shunliuniliu/QuadBot-TD/README.md

# QuadBot-TD
QuadBot-TA

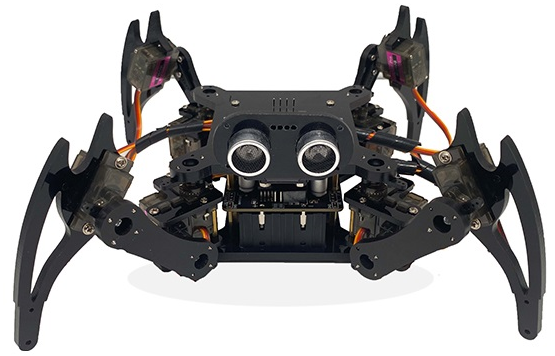
[picture p1: QuadBot-TA.png]


QuadBot-TD

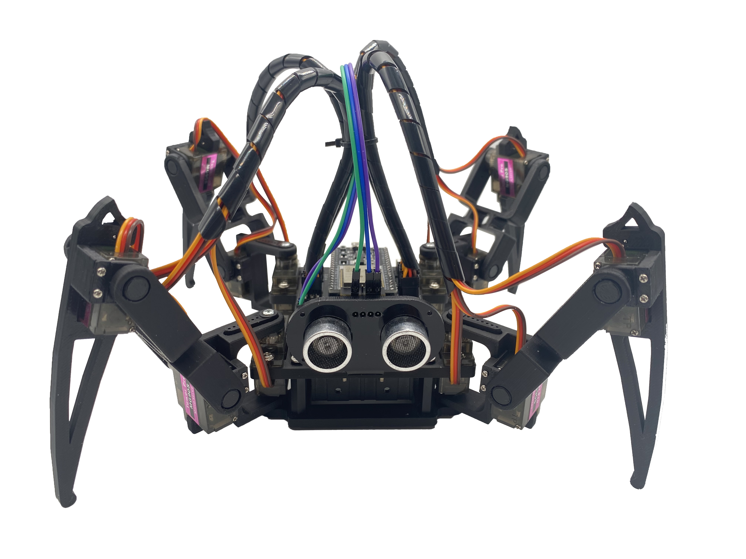
[picture p2: QuadBot-TD.jpg]


QuadBot-TAD

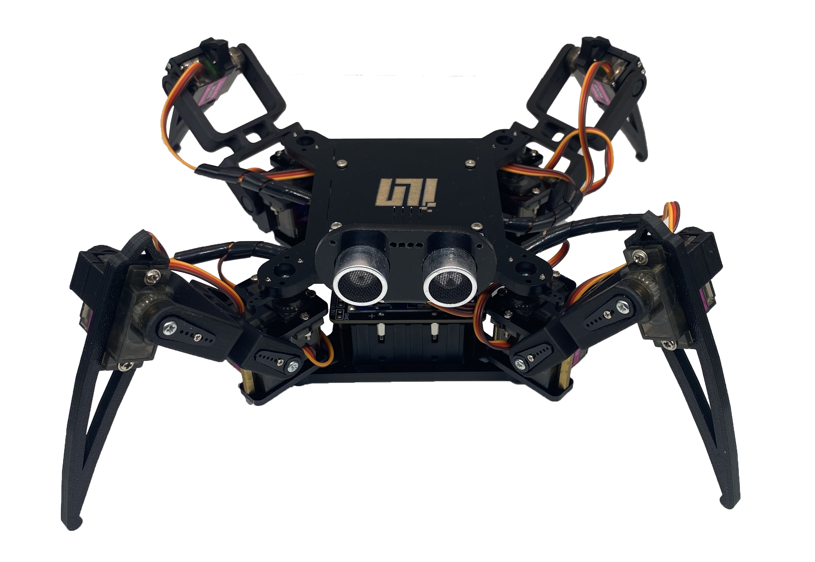
[picture p3: QuadBot-TAD.png]
