shunliuniliu/QuadBot-TD/QuadBot-TAD-EN/01_ReadMeFirst/ReadMe.pdf

1. The new version of the code replaces pin 12 with pin 26, that is, the servo connecting pin 12 in the manual needs to be connected to pin 26 .
2. Please select 18650 battery with flat head .
3. Please fully charge the battery when using it for the first time .
