shunliuniliu/QuadBot-TD/QuadBot-TA.jpg

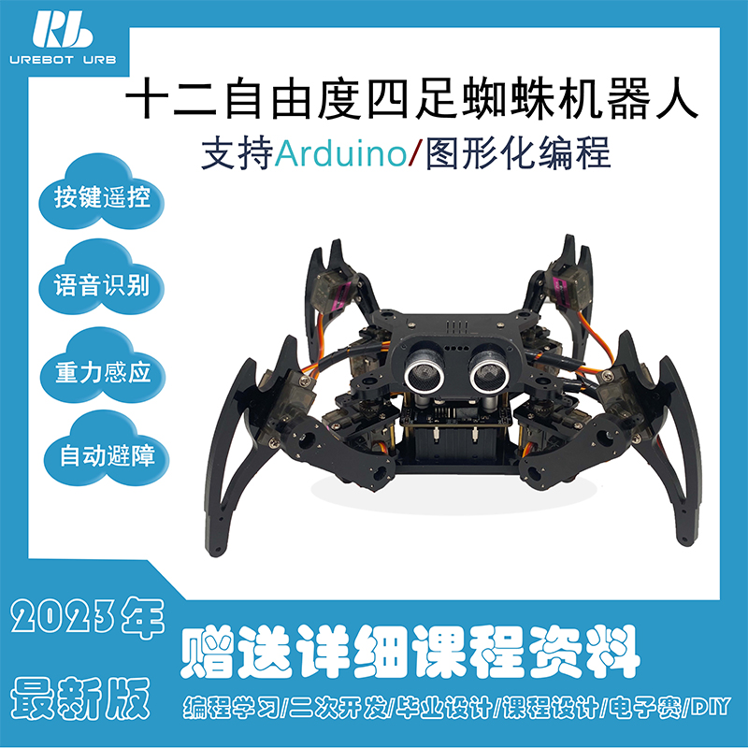
QuadBot-TA.jpg
