shunliuniliu/QuadBot-TD/QuadBot-TAD-EN/09_3D_Model/Body-Down-TAD-V1.0.STL

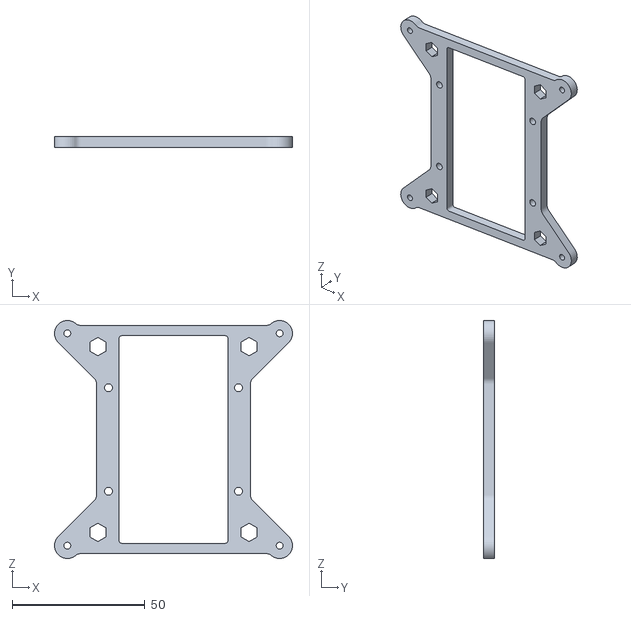
[picture p7: CAD file, 2023-09-18]
QuadBot-TAD-EN/09_3D_Model/Body-Down-TAD-V1.0.STL
89.7 x 4.00 x 89.7
