shunliuniliu/QuadBot-TD/QuadBot-TD-EN/09_3D_Model/S-Hold.STL

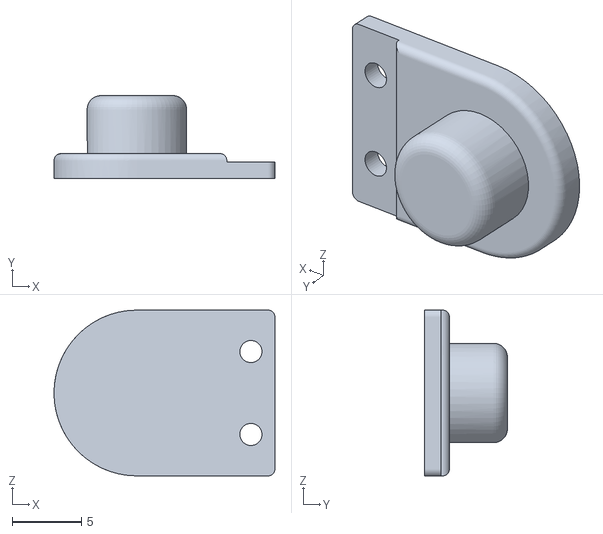
[picture p8: CAD file, 2023-07-27]
QuadBot-TD-EN/09_3D_Model/S-Hold.STL
16.0 x 6.00 x 12.0
