shunliuniliu/QuadBot-TD/QuadBot-TAD-EN/09_3D_Model/Cover-V1.0.STL

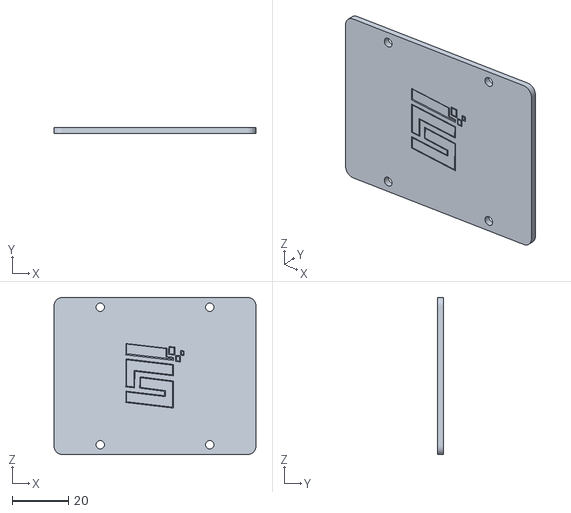
[picture p9: CAD file, 2023-09-18]
QuadBot-TAD-EN/09_3D_Model/Cover-V1.0.STL
72.0 x 2.00 x 56.0
