shunliuniliu/QuadBot-TD/QuadBot-TD-EN/09_3D_Model/Coxa-R-MG90S-V1.0.STL

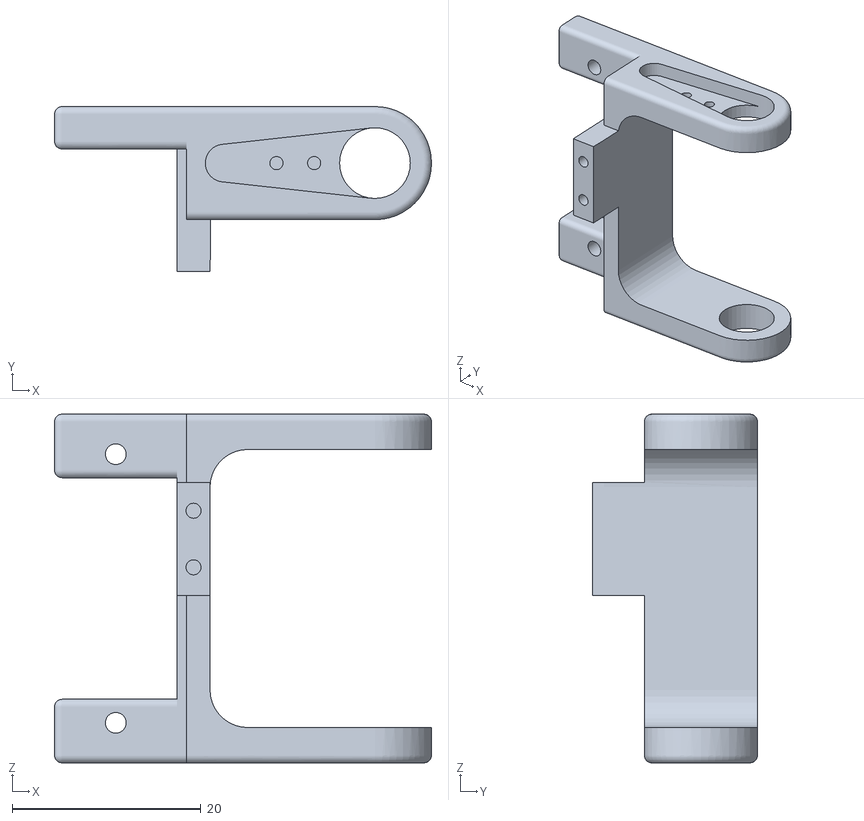
[picture p10: CAD file, 2023-07-27]
QuadBot-TD-EN/09_3D_Model/Coxa-R-MG90S-V1.0.STL
40.0 x 17.5 x 37.0
