shunliuniliu/QuadBot-TD/QuadBot-TAD-EN/09_3D_Model/Body-Up-A-V1.0.STL

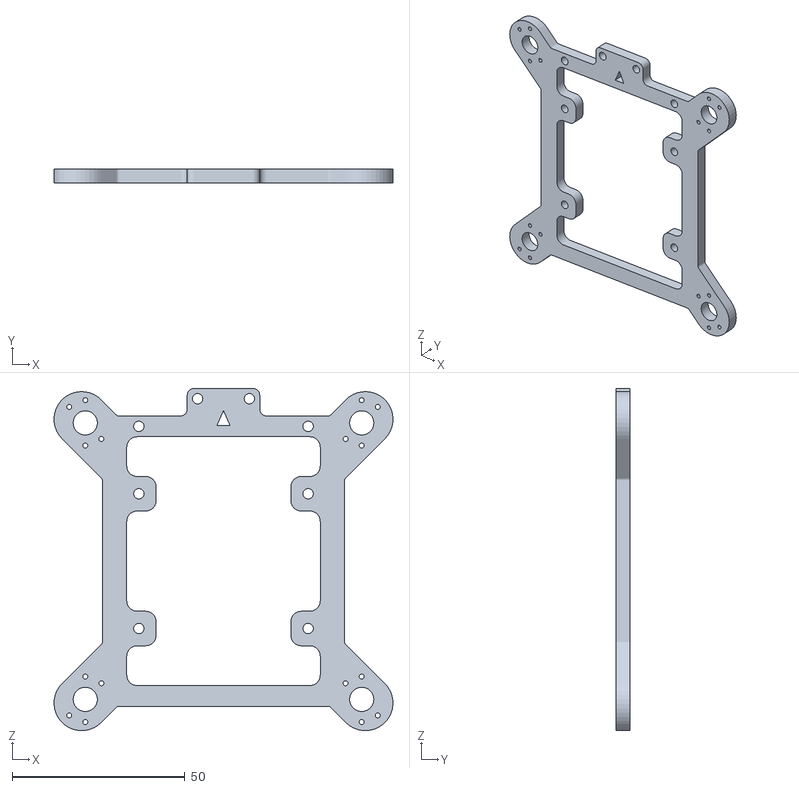
[picture p11: CAD file, 2023-09-18]
QuadBot-TAD-EN/09_3D_Model/Body-Up-A-V1.0.STL
98.1 x 4.00 x 99.1
