shunliuniliu/QuadBot-TD/QuadBot-TD-EN/09_3D_Model/Body-Down-V2.STL

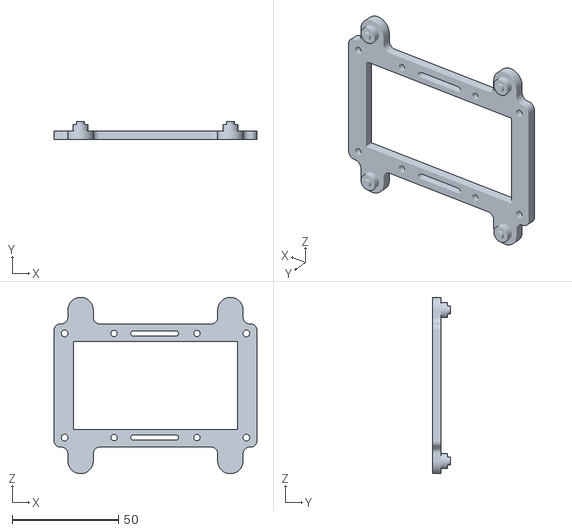
[picture p12: CAD file, 2023-07-27]
QuadBot-TD-EN/09_3D_Model/Body-Down-V2.STL
95.5 x 8.30 x 83.0
