shunliuniliu/QuadBot-TD/QuadBot-TAD-EN/09_3D_Model/Servo-Holder-Up-A-V1.0.STL

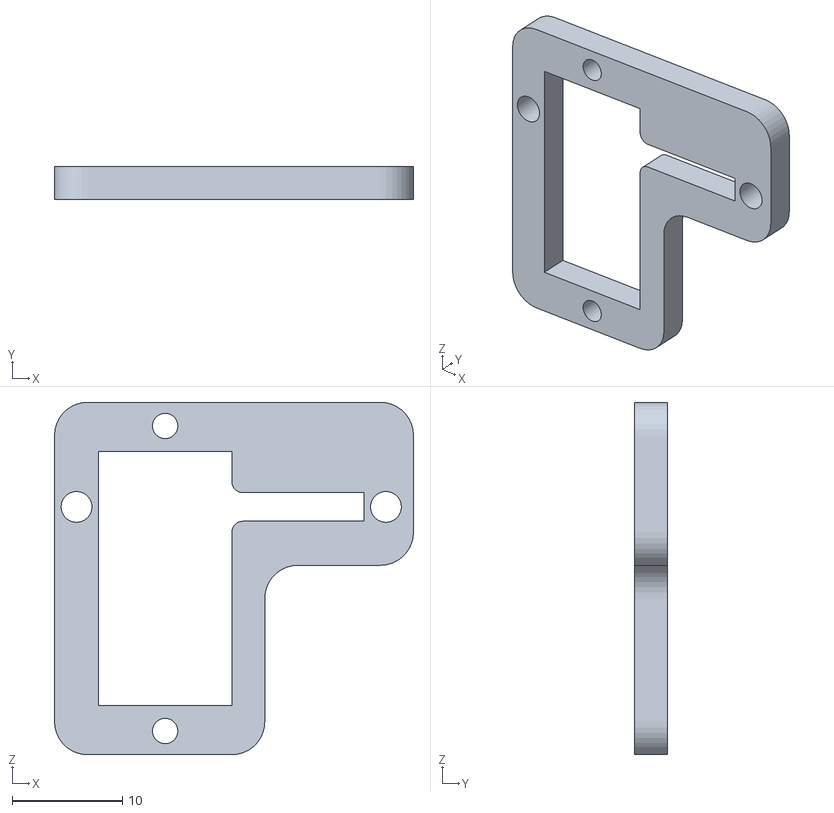
[picture p13: CAD file, 2023-09-18]
QuadBot-TAD-EN/09_3D_Model/Servo-Holder-Up-A-V1.0.STL
32.6 x 3.00 x 32.0
