shunliuniliu/QuadBot-TD/QuadBot-TAD-EN/09_3D_Model/Servo-Holder-Down-A-V1.1.STL

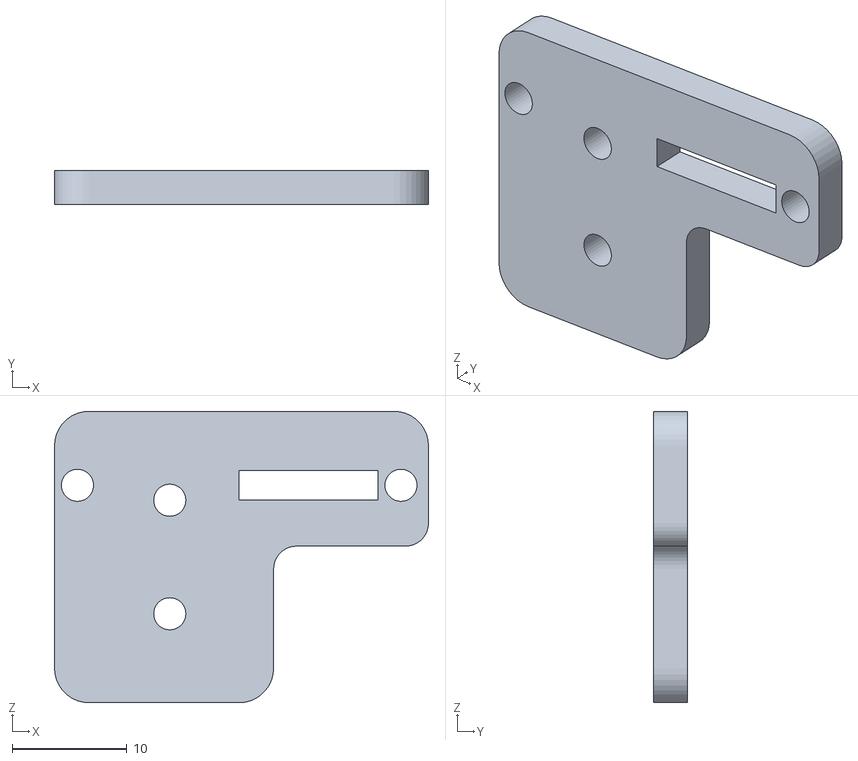
[picture p14: CAD file, 2023-09-18]
QuadBot-TAD-EN/09_3D_Model/Servo-Holder-Down-A-V1.1.STL
32.6 x 3.00 x 25.4
