shunliuniliu/QuadBot-TD/QuadBot-TD-EN/09_3D_Model/ESP32-Body-Up-V1.0.STL

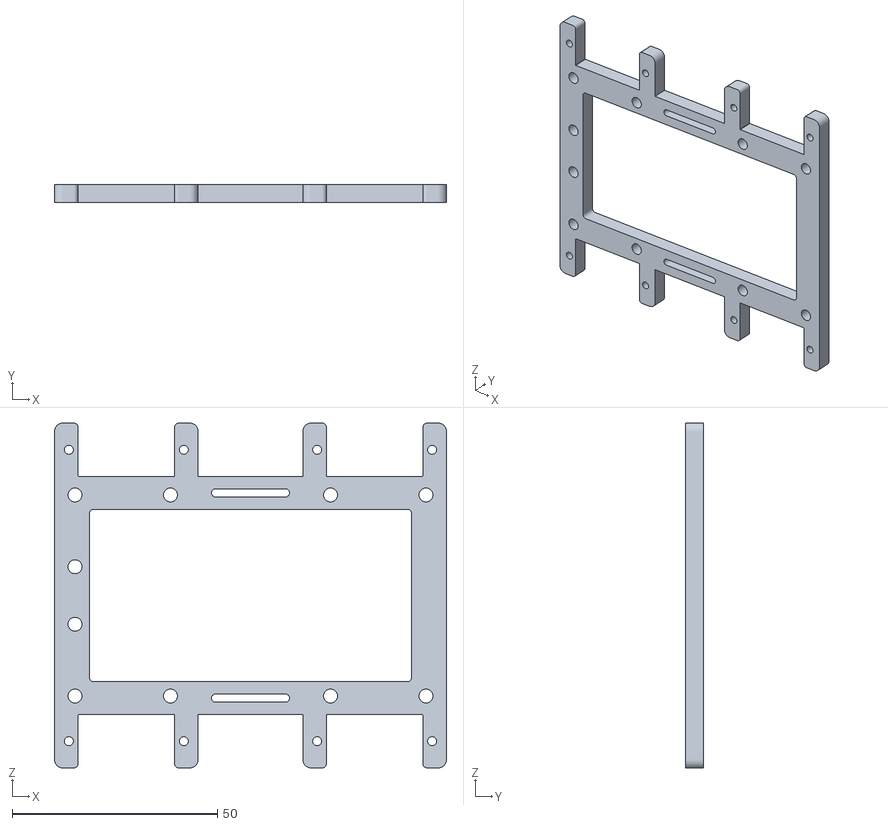
[picture p15: CAD file, 2023-07-27]
QuadBot-TD-EN/09_3D_Model/ESP32-Body-Up-V1.0.STL
95.5 x 4.50 x 84.0
