shunliuniliu/QuadBot-TD/QuadBot-TAD-EN/09_3D_Model/Servo-Bottom.STL

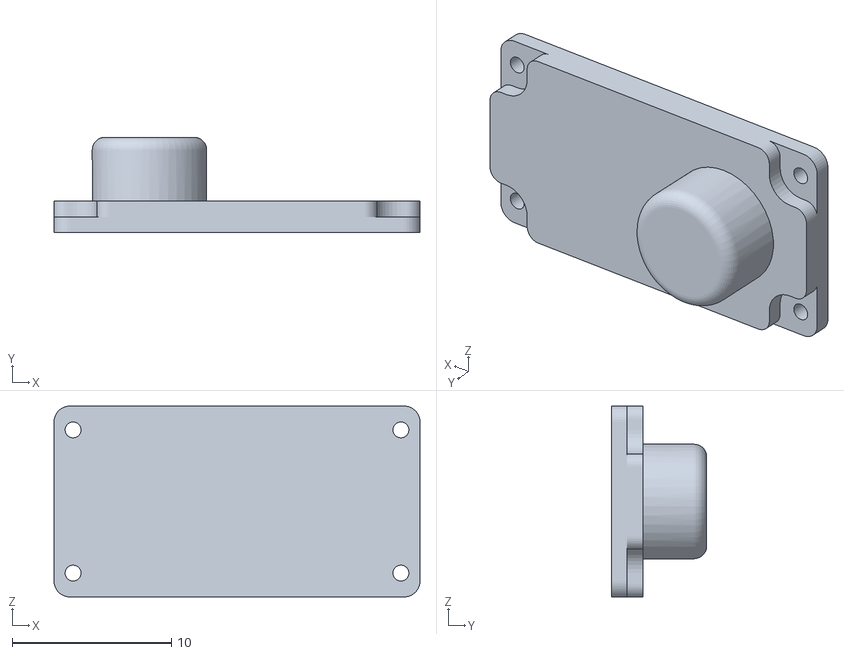
[picture p16: CAD file, 2023-09-18]
QuadBot-TAD-EN/09_3D_Model/Servo-Bottom.STL
23.0 x 6.00 x 12.0
