shunliuniliu/QuadBot-TD/QuadBot-TAD-EN/09_3D_Model/Sonar-Holder-V2.0.STL

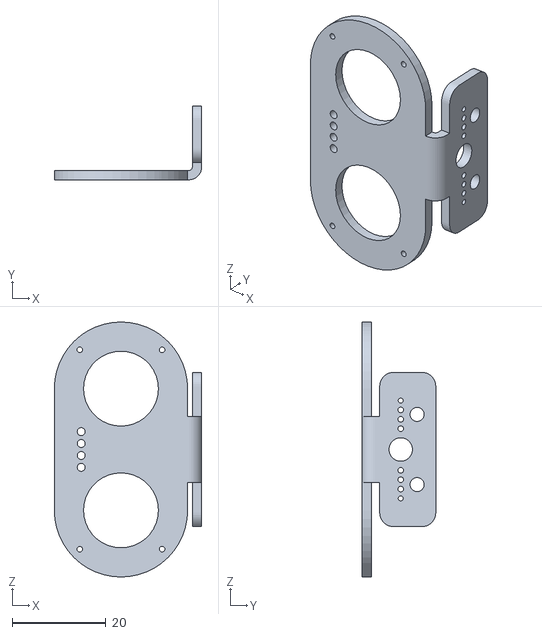
[picture p17: CAD file, 2023-07-27]
QuadBot-TAD-EN/09_3D_Model/Sonar-Holder-V2.0.STL
31.5 x 15.7 x 54.5
