shunliuniliu/QuadBot-TD/QuadBot-TAD-EN/09_3D_Model/Tibia-L-MG90S.STL

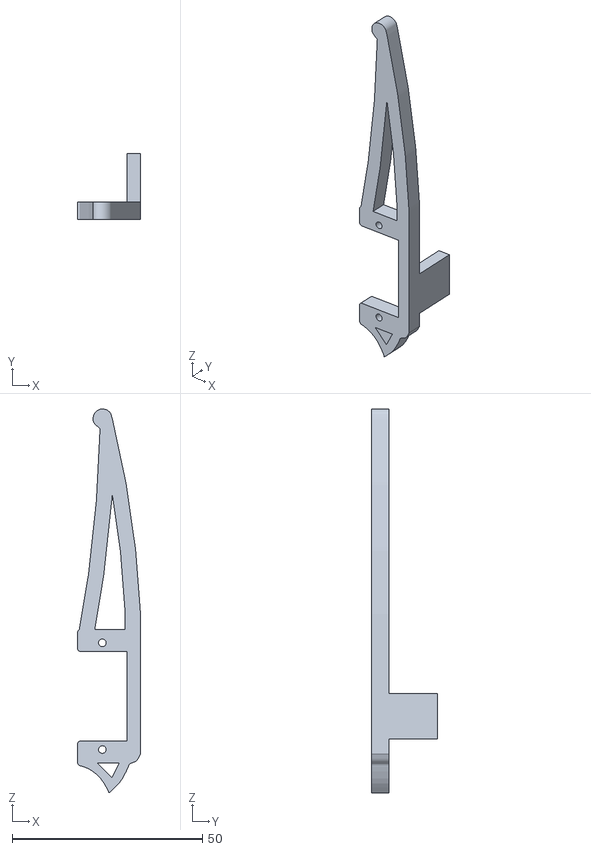
[picture p18: CAD file, 2023-07-27]
QuadBot-TAD-EN/09_3D_Model/Tibia-L-MG90S.STL
16.5 x 17.3 x 100.8
