shunliuniliu/QuadBot-TD/QuadBot-TAD-EN/09_3D_Model/Tibia-R-MG90S.STL

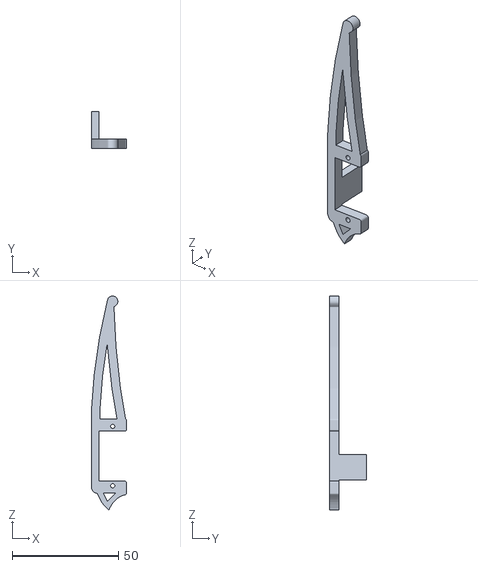
[picture p19: CAD file, 2023-07-27]
QuadBot-TAD-EN/09_3D_Model/Tibia-R-MG90S.STL
16.5 x 17.3 x 100.8
