shunliuniliu/QuadBot-TD/QuadBot-TAD-EN/09_3D_Model/Femur-MG90S-V1.0.STL

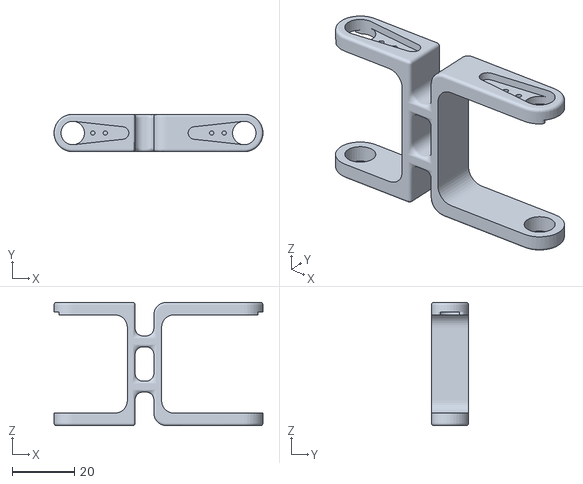
[picture p20: CAD file, 2023-07-27]
QuadBot-TAD-EN/09_3D_Model/Femur-MG90S-V1.0.STL
67.0 x 12.0 x 39.5
