shunliuniliu/QuadBot-TD/(list of files, cad)

Other CAD files:
QuadBot-TD-EN/09_3D_Model/Coxa-L-MG90S-V1.0.STL
