shunliuniliu/QuadBot-TD/QuadBot-TAD-EN/03_Tutorial_&_Code/Lesson0 Setting Development Enviornment/Lesson0 Setting Development Enviornment.pdf

# Arduino IDE

Arduino IDE, as an open source software, is developed based on the Processing IDE and is an integrated development environment officially launched by Arduino

The QuadBot-T kit was programmed and debugged using the Arduino IDE

## So, where can we download the arduino IDE?

## Step 1:

Go to https://www.arduino.cc/en/Main/Software, you will see the following page. The version provided on this website is usually the latest version, the actual version may be more recent than the version in the picture. Version 1.8.19 is recommended.

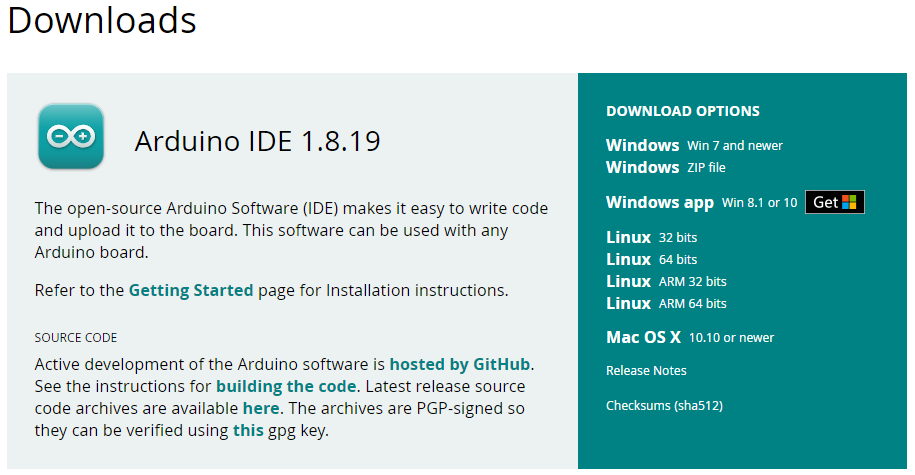
[picture p21: figure]

## Step 2:

Download development software suitable for your computer's operating system. Take Windows as an example. If you are a macOS, please pull to the end. You can use the EXE installation package or the green package.
The following is the executable for the installer. Click on "Windows Installer" as shown in the picture below。

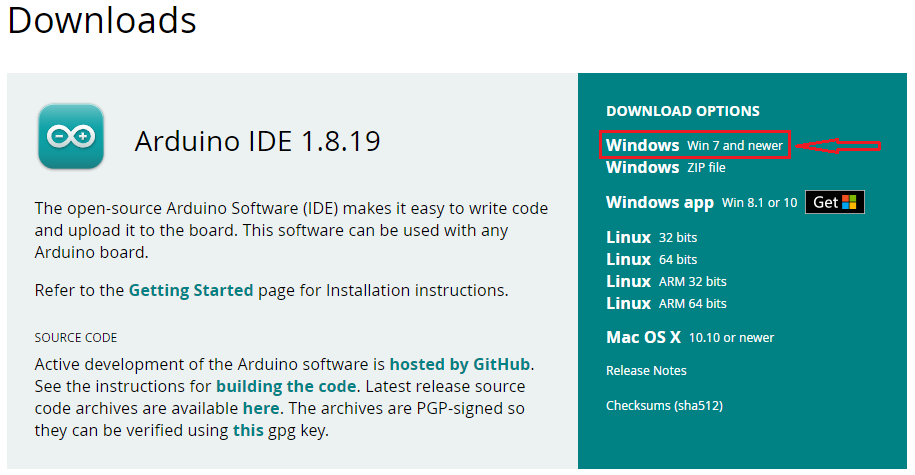
[picture p22: figure]

## Step 3:

The following interface appears. Click the "JUST DOWNLOAD" button to download the software.

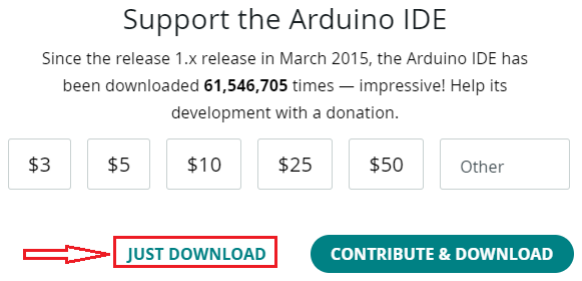
[picture p23: figure]

Download file：

## Step 4:

These are available from the tutorials we provide, and the version we provide is the most recent at the time this course was produced. Double-click the exe file. The following interface appears. Select "I Agree".
。

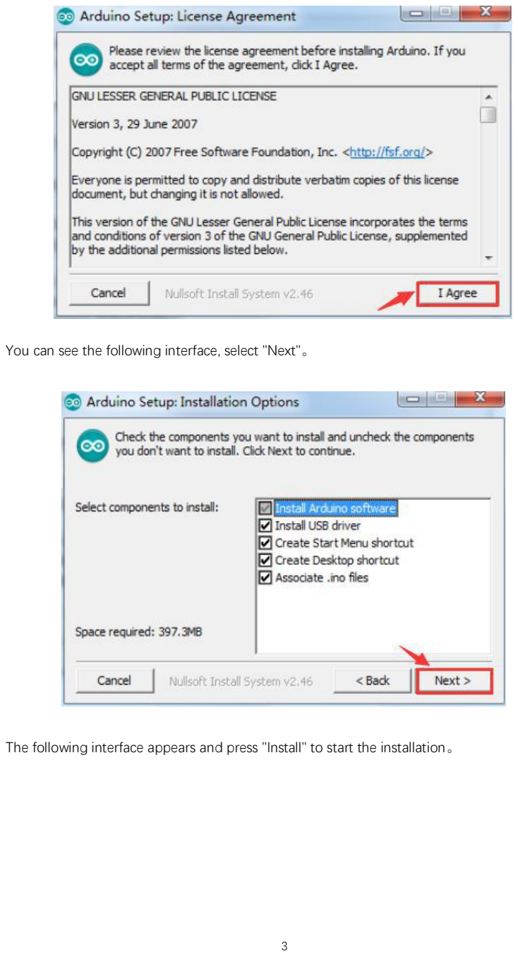
[picture p24: page 3]

You can see the following interface, select "Next"。

The following interface appears and press "Install" to start the installation。

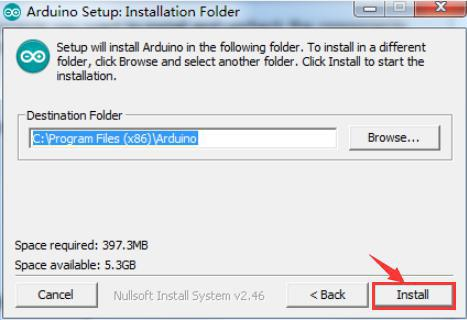
[picture p25: figure]

Finally, the following interface appears. Please select "Install" to ensure the correctness of the development environment installation。

## Step 5:

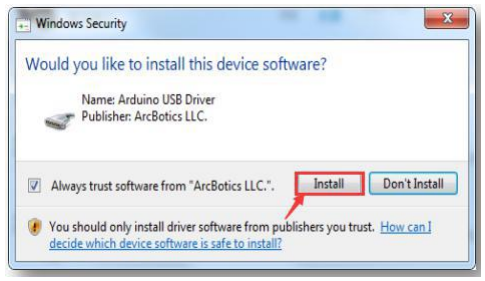
[picture p26: figure]

Next, the following icons will appear on the desktop。

Double-click the icon to enter the development environment。

## Step 6:

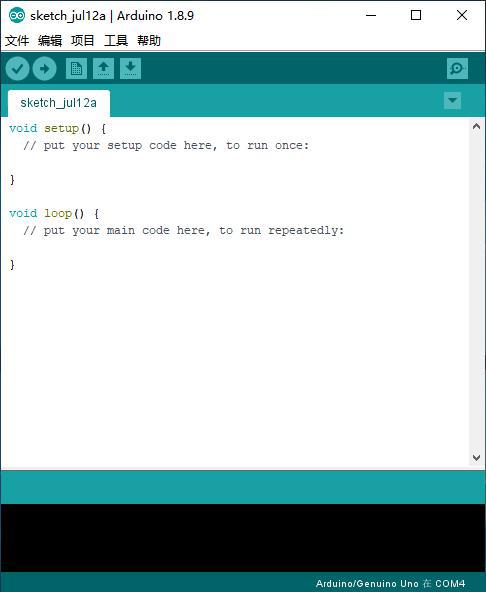
[picture p27: figure]

The main controller we use here is ESP32-WROOM-32，so you need to install the ESP32 plug-in，in the Arduino IDE opened in the previous step, find "File ->Preferences"。Add the
following | web | address | to | the | "Add-on | Board | Manager | web | address:"
https://dl.espressif.com/dl/package_esp32_index.json，as shown in the figure below。

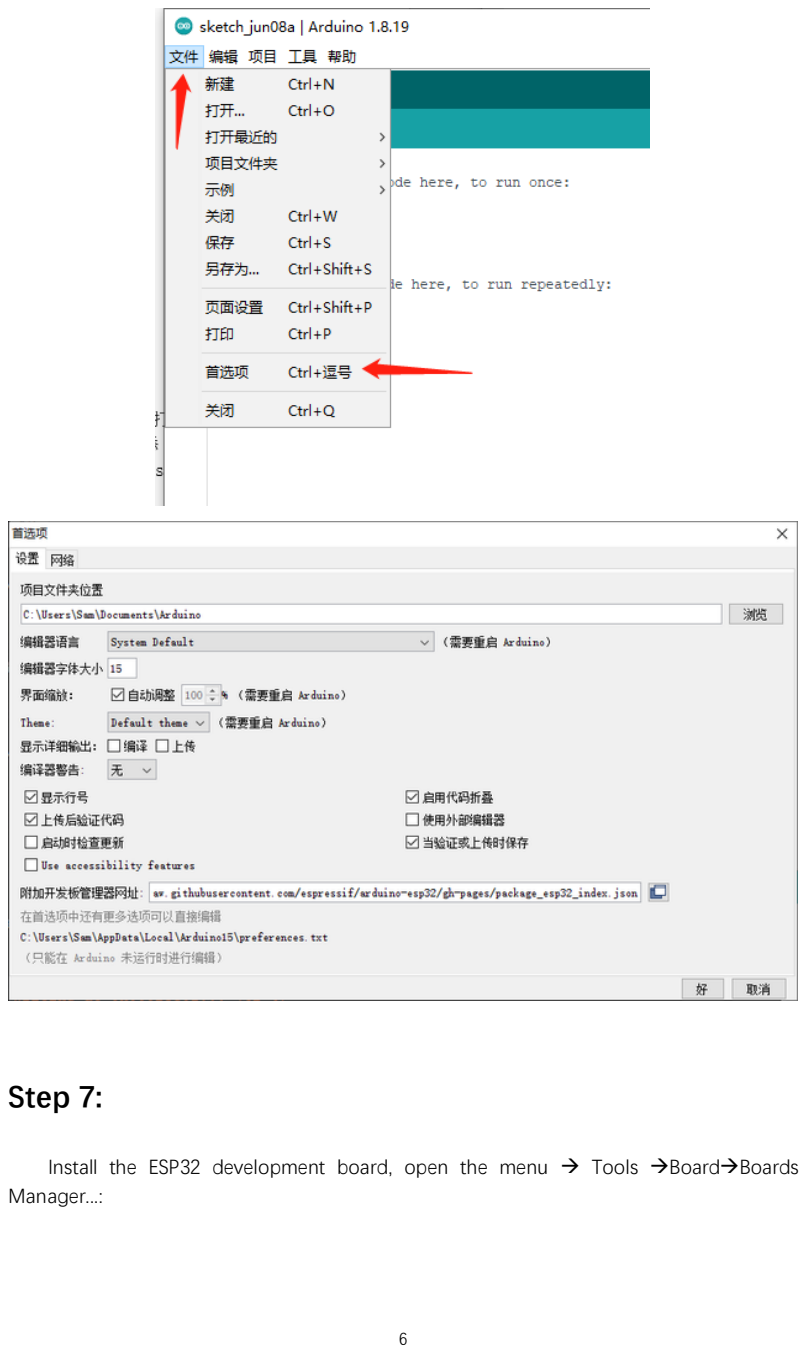
[picture p28: page 6]

## Step 7:

Install the ESP32 development board, open the menu → Tools →Board→Boards Manager...:

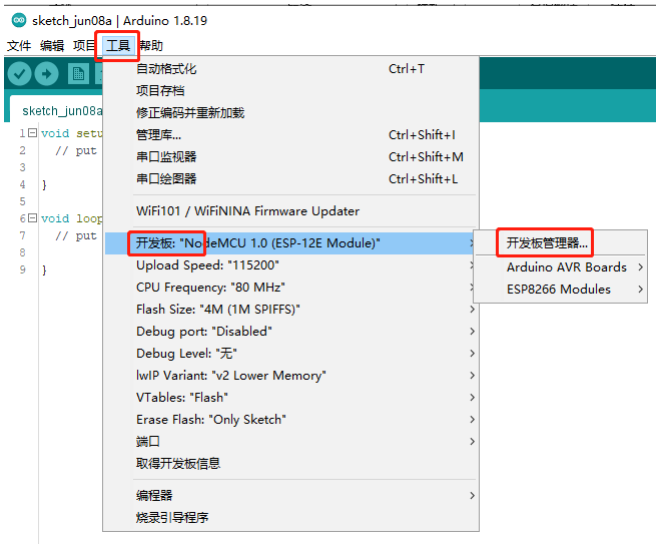
[picture p29: figure]

开发板管理器入口

Enter esp32 in the boards manager to search for the esp32 development board, and then

click Install, as shown in the following figure（Note: Version 1.0.6 needs to be

## installed！！！）

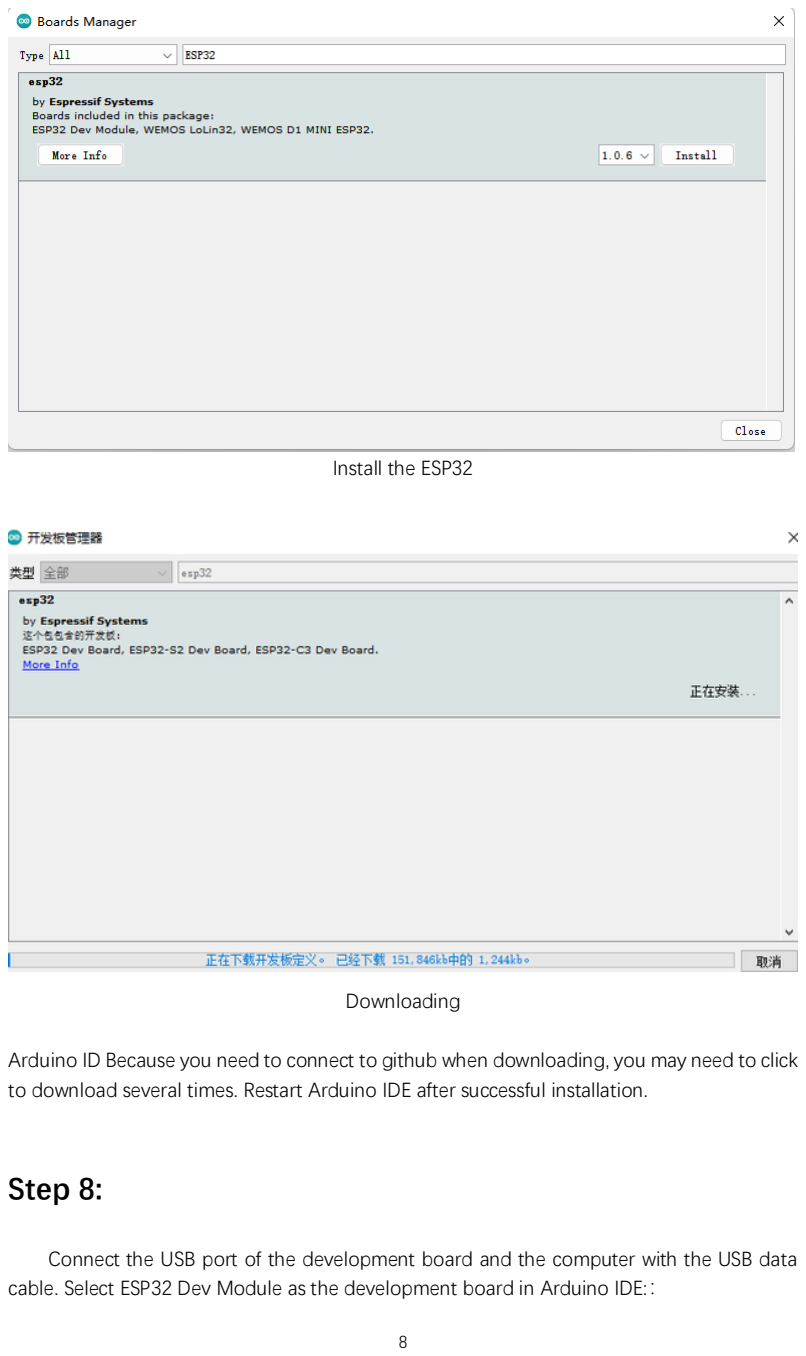
[picture p30: page 8]

Install the ESP32

Downloading

Arduino ID Because you need to connect to github when downloading, you may need to click to download several times. Restart Arduino IDE after successful installation.

## Step 8:

Connect the USB port of the development board and the computer with the USB data cable. Select ESP32 Dev Module as the development board in Arduino IDE:：

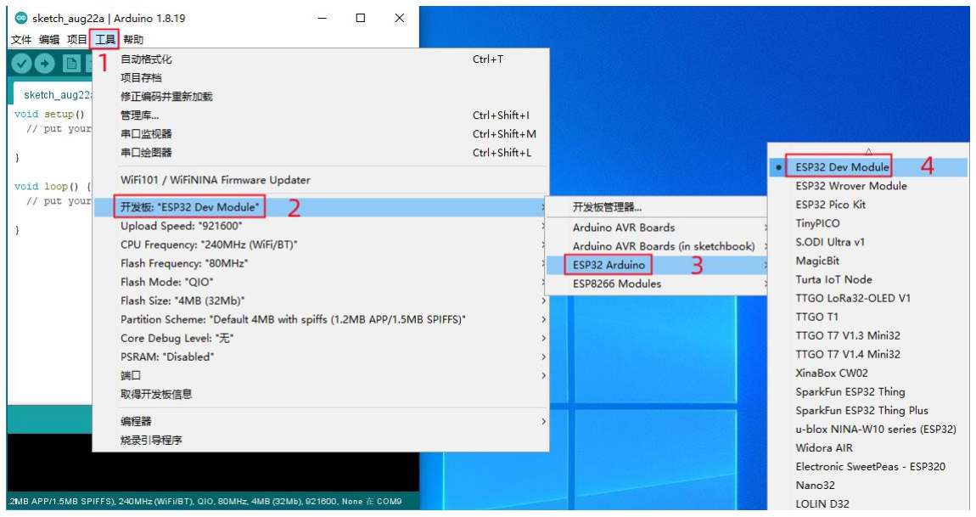
[picture p31: figure]

## Step 9:

Test whether the software is installed successfully. Click "File → Example → ESP32 → ChipID → GetChipID" in turn. Select "COM9" in "Tools" ->"Port". (On the same computer in Arduino 1.8.9, each ESP32 development board has a different COM number. You should select the COM number actually displayed.)

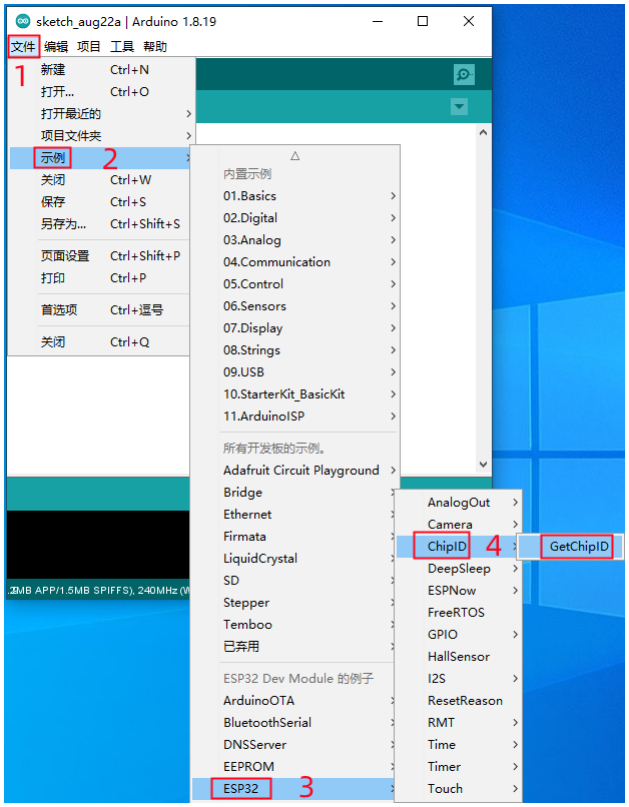
[picture p32: figure]

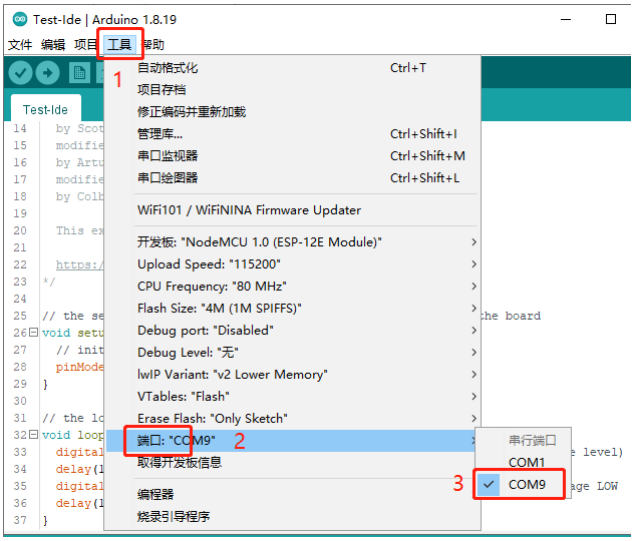
[picture p33: figure]

## Step 10:

Click the download button to download the program into ESP32. As shown in the figure below.

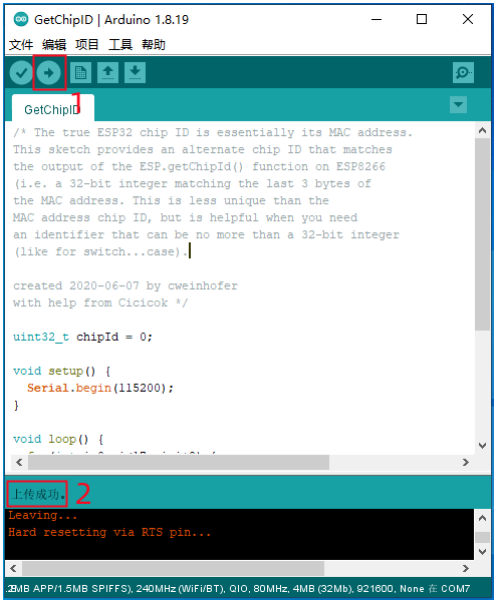
[picture p34: figure]

When you see the prompt "Upload succeeded" in prompt 2, the download is completed.

## Step 11:

Click the Serial Monitor button in the upper right corner. As shown in the figure below：

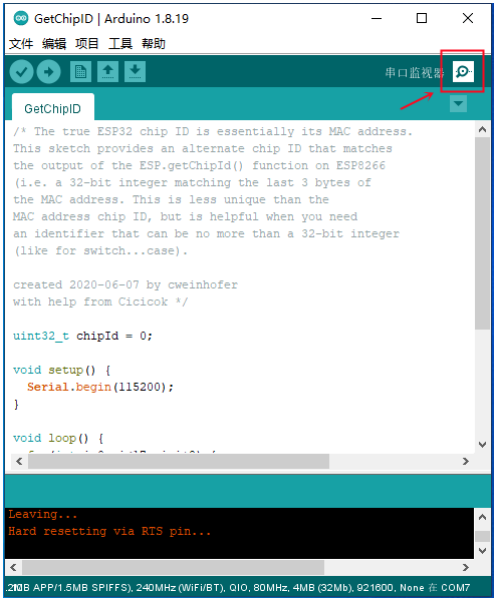
[picture p35: figure]

Select 115200 baud rate in the pop-up Serial Monitor window, as shown below:

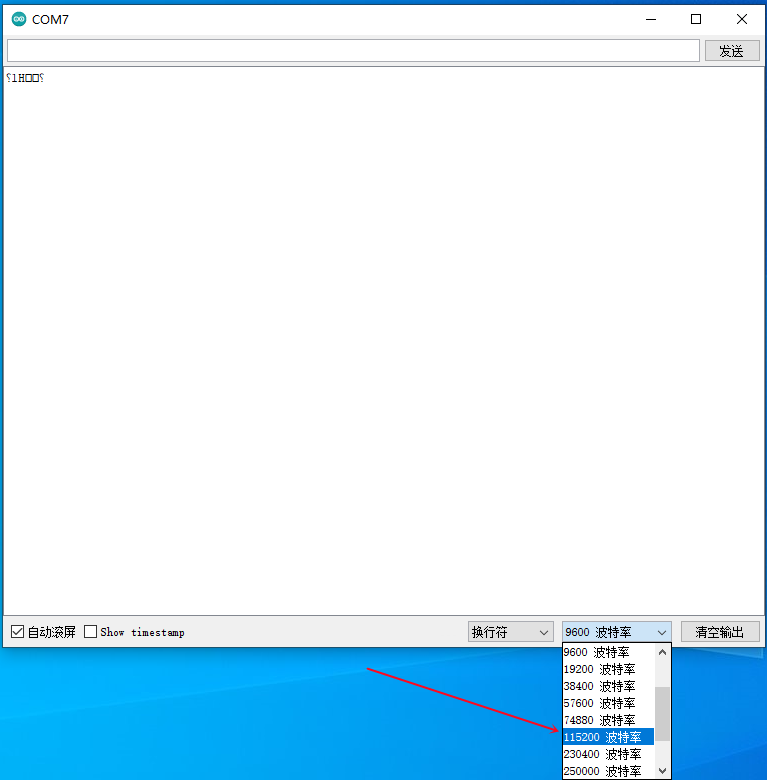
[picture p36: figure]

Under normal circumstances, you can see that the ID information of the chip is displayed correctly in the window. So far, the Arduino IDE software has been successfully installed.
