shunliuniliu/QuadBot-TD/QuadBot-TAD-EN/03_Tutorial_&_Code/Lesson6 Mobile App Control Robot/Lesson6 Mobile App Control Robot/Lesson6 Mobile App Control Robot.pdf

# 1. Mobile phone APP control

## 1.1. Open the source code

Open the information package we provide, locate to the "Course 7 Mobile APP Control Q uad Bot_T _ESP D" folder, and double-click Q uad Bot_T _ESP D. And ino, open the source code.→→

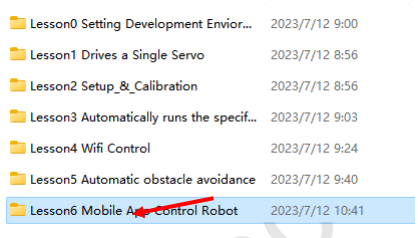
[picture p89: figure]

## 1.2. To compile the source code

Click the 1 compile button as shown in the figure below. If there is no problem, the compilation completion prompt in 2 appears.

# Urebot

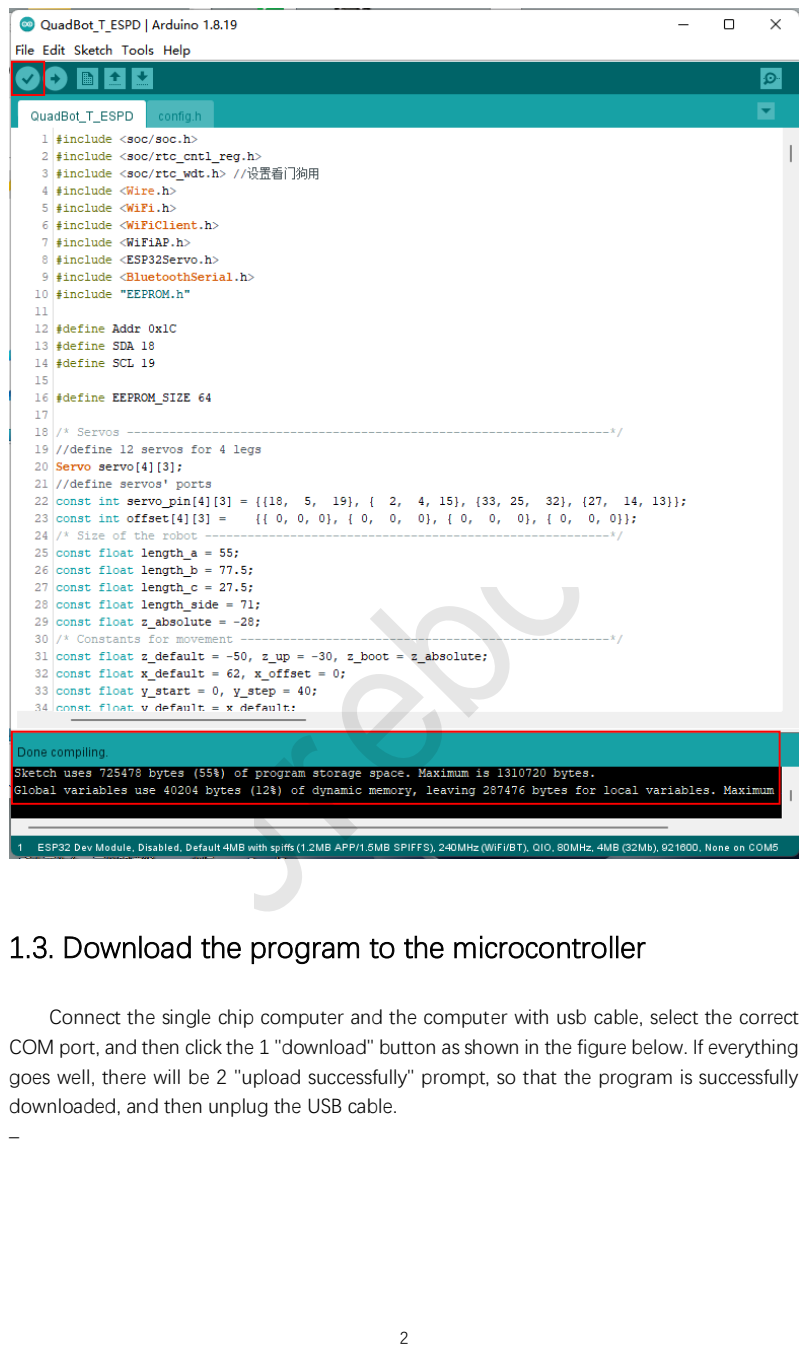
[picture p90: page 2]

## 1.3. Download the program to the microcontroller

Connect the single chip computer and the computer with usb cable, select the correct COM port, and then click the 1 "download" button as shown in the figure below. If everything goes well, there will be 2 "upload successfully" prompt, so that the program is successfully downloaded, and then unplug the USB cable.
–

# Urebot

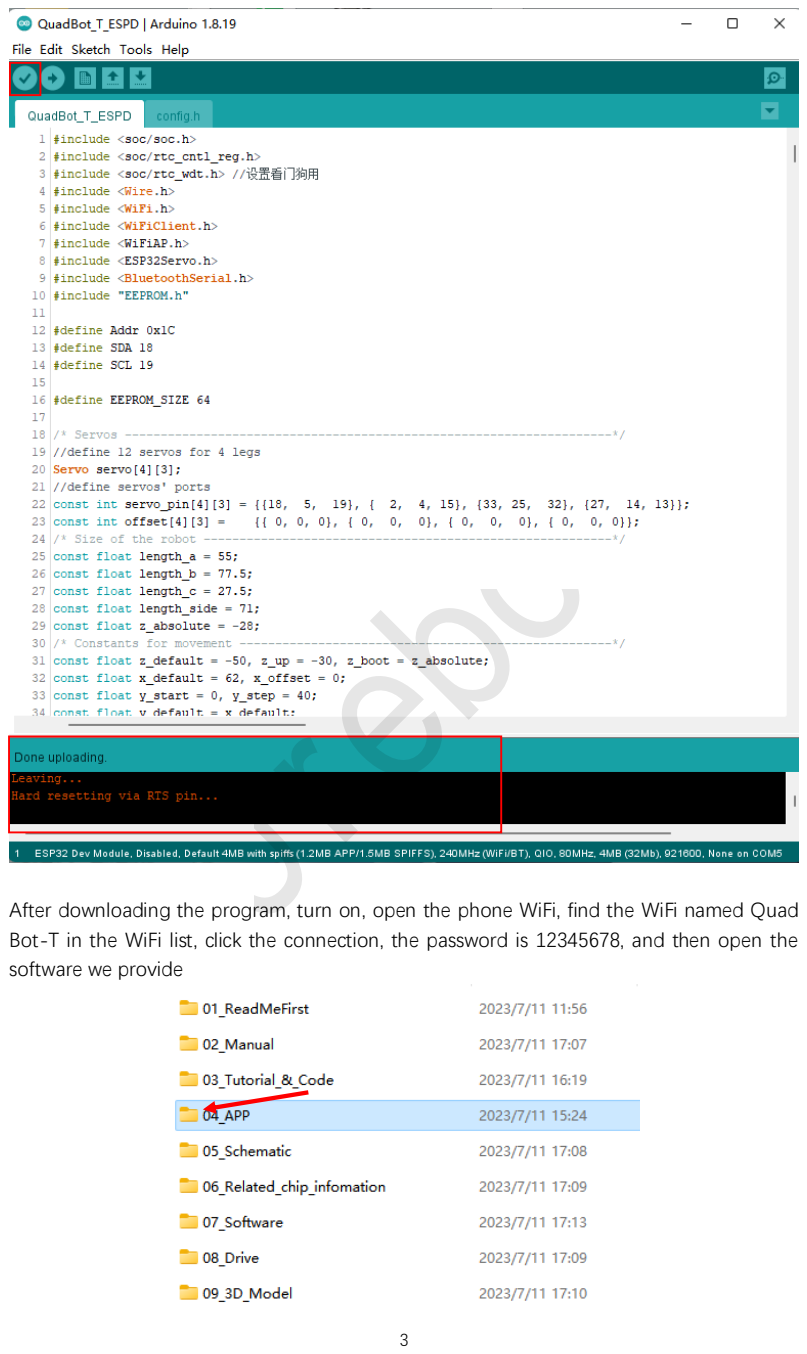
[picture p91: page 3]

After downloading the program, turn on, open the phone WiFi, find the WiFi named Quad Bot-T in the WiFi list, click the connection, the password is 12345678, and then open the software we provide

# Urebot

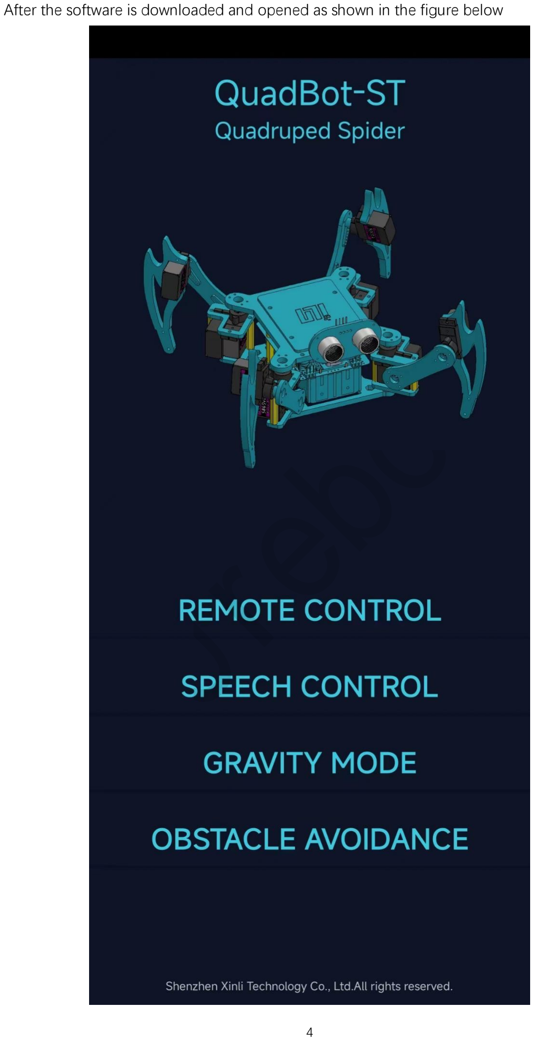
[picture p92: page 4]

After the software is downloaded and opened as shown in the figure below

# Urebot

1. Key control, which can be manually controlled

# Urebot

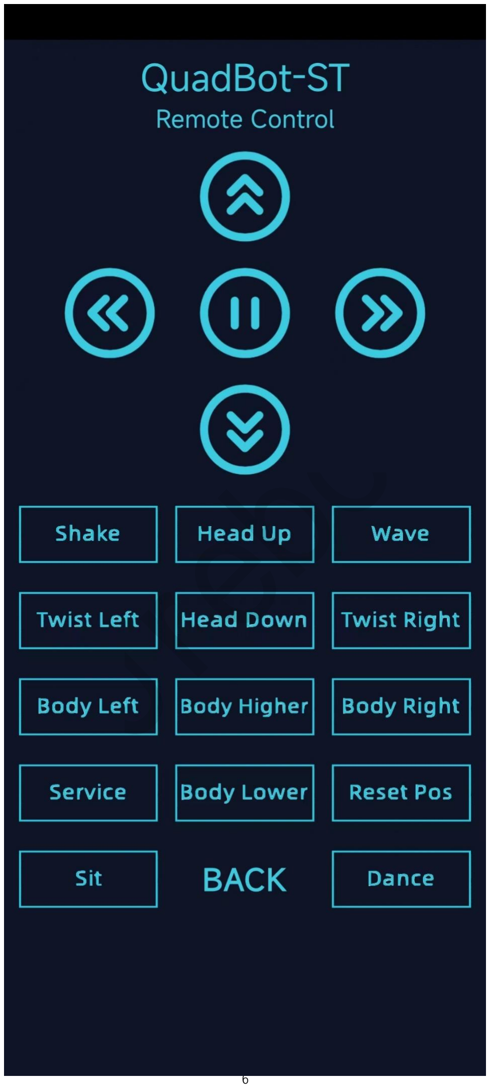
[picture p93: page 6]

# Urebot

2. Voice remote control, when you hold the microphone in the middle of the screen, and then release,
(Instruction: forward, back, turn left, turn right, look up, wave, shake hands, left twist, right twist, lift, squat, service, reset, sit, dance), the spider performs the corresponding action

# Urebot

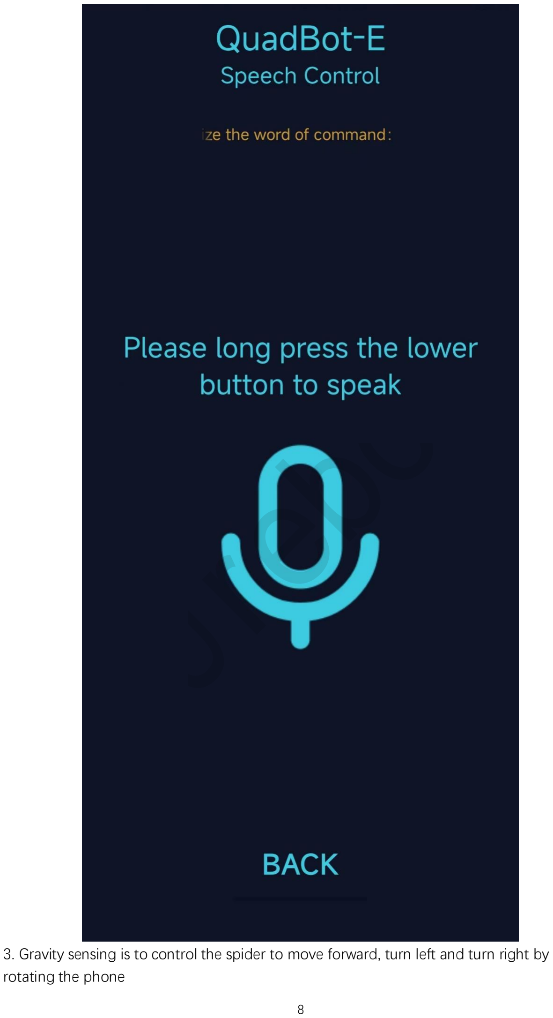
[picture p94: page 8]

3. Gravity sensing is to control the spider to move forward, turn left and turn right by rotating the phone

# Urebot

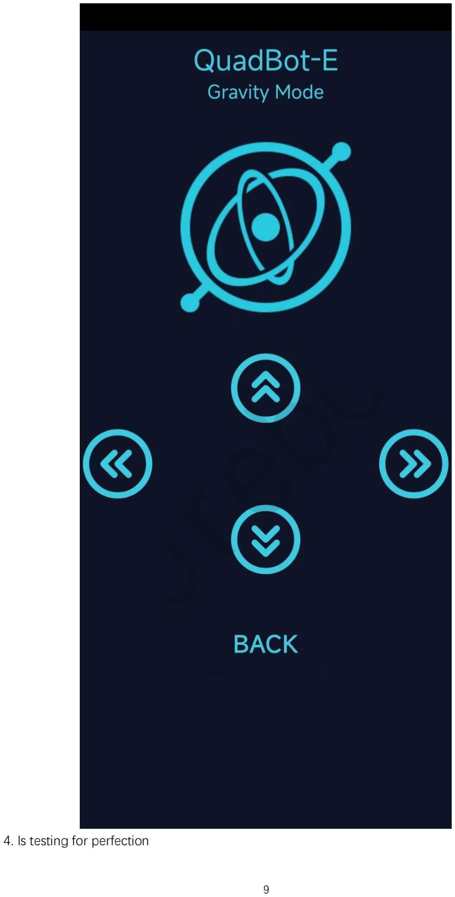
[picture p95: page 9]

4. Is testing for perfection

# Urebot

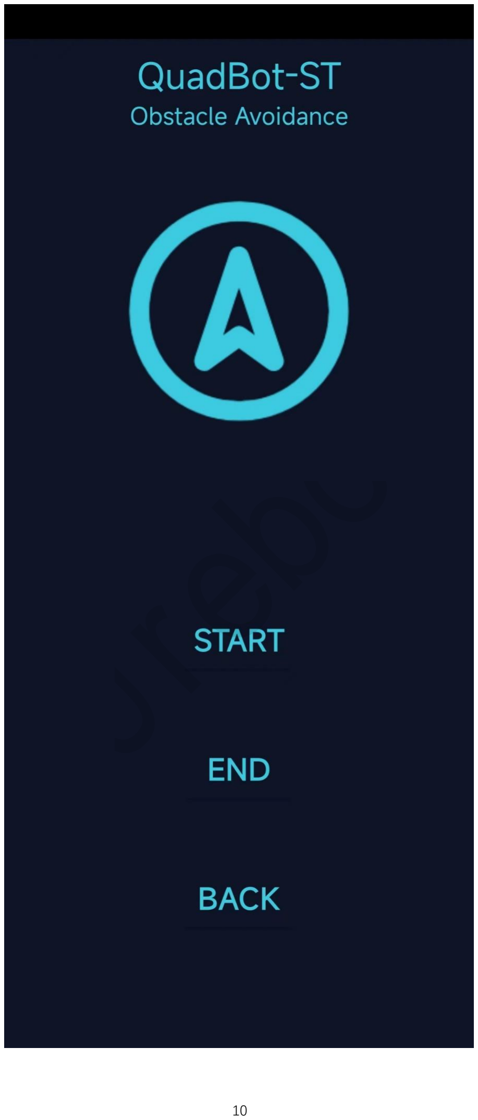
[picture p96: page 10]

# Urebot
