shunliuniliu/QuadBot-TD/QuadBot-TAD-EN/03_Tutorial_&_Code/Lesson2 Setup_&_Calibration/Lesson2 Setup_&_Calibration.pdf

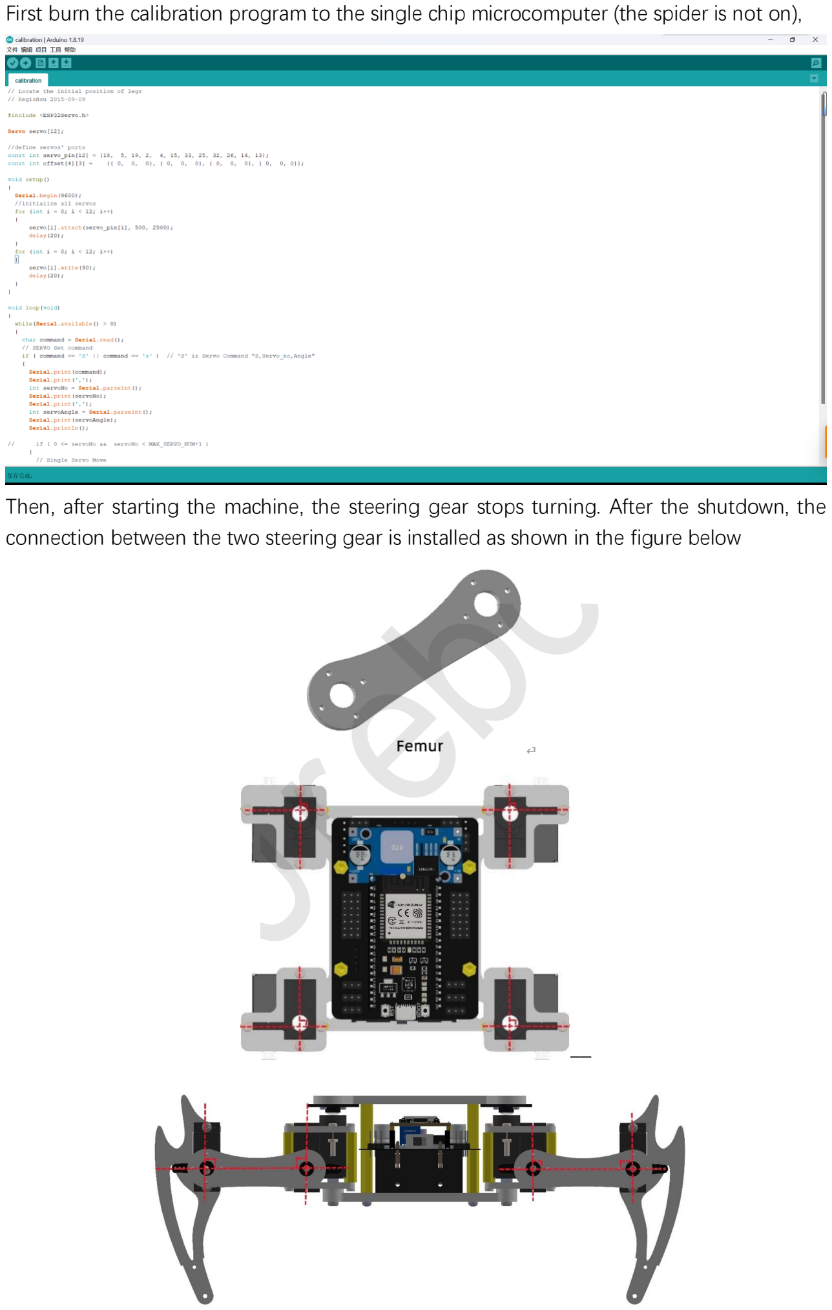
[picture p97: page 1]

First burn the calibration program to the single chip microcomputer (the spider is not on),

Then, after starting the machine, the steering gear stops turning. After the shutdown, the connection between the two steering gear is installed as shown in the figure below

––

# Urebot

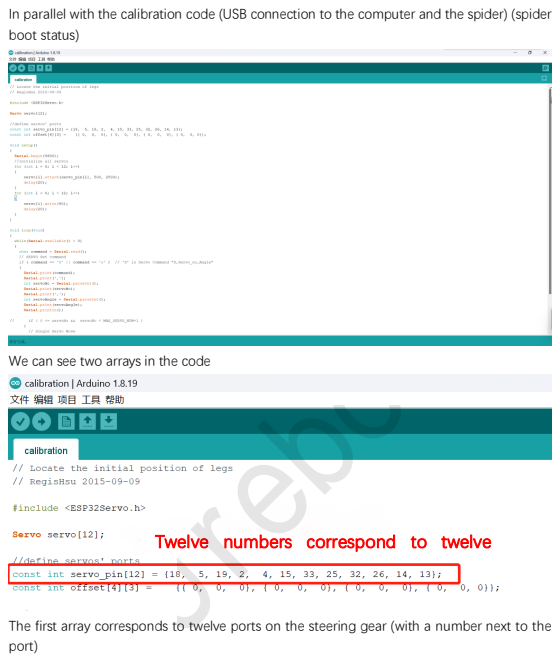
[picture p98: page 2]
Urebot

In parallel with the calibration code (USB connection to the computer and the spider) (spider
boot status)

We can see two arrays in the code

The first array corresponds to twelve ports on the steering gear (with a number next to the
port)

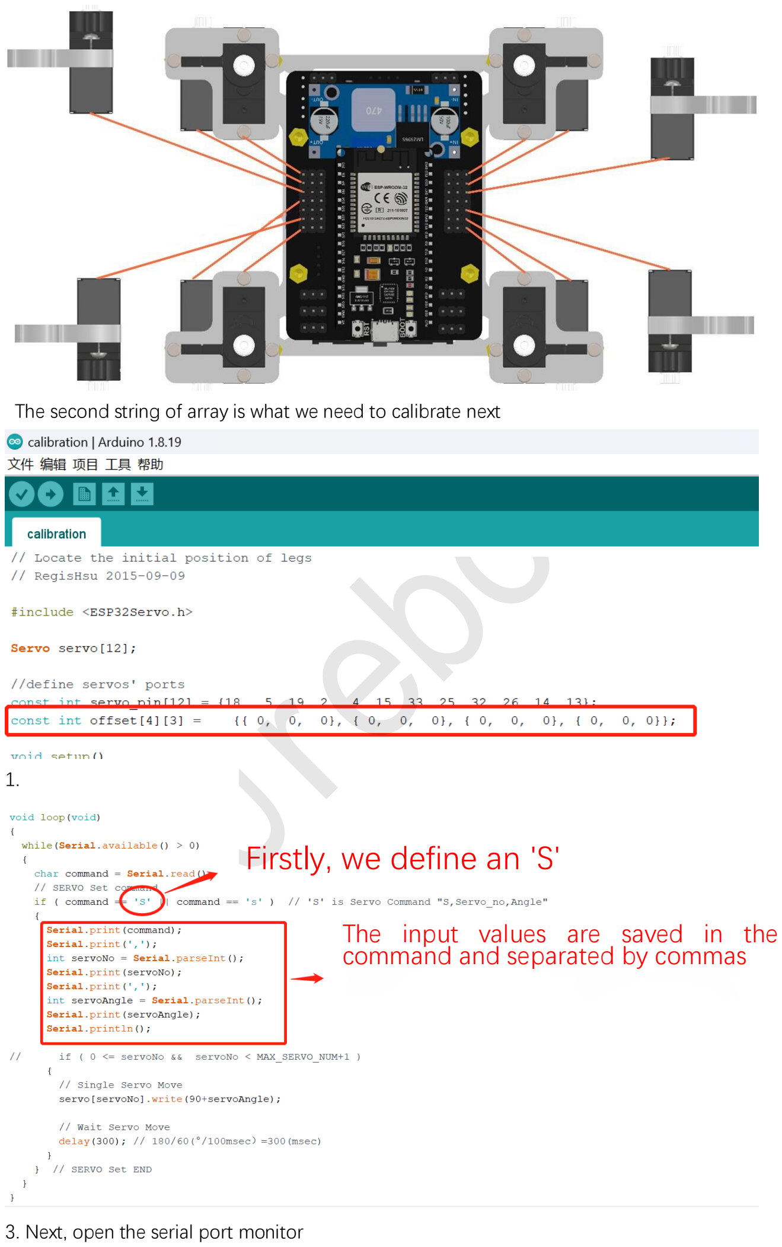
[picture p99: page 3]

The second string of array is what we need to calibrate next

1.

3. Next, open the serial port monitor

# Firstly, we define an 'S'

## The input values are saved in the command and separated by commas

# Urebot

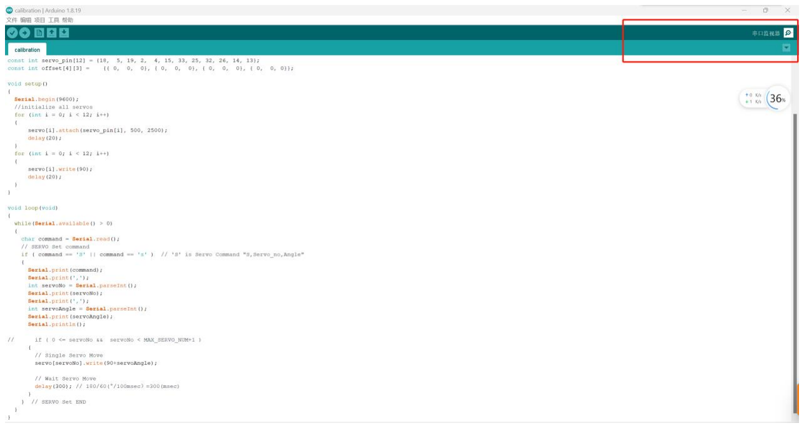
[picture p100: figure]
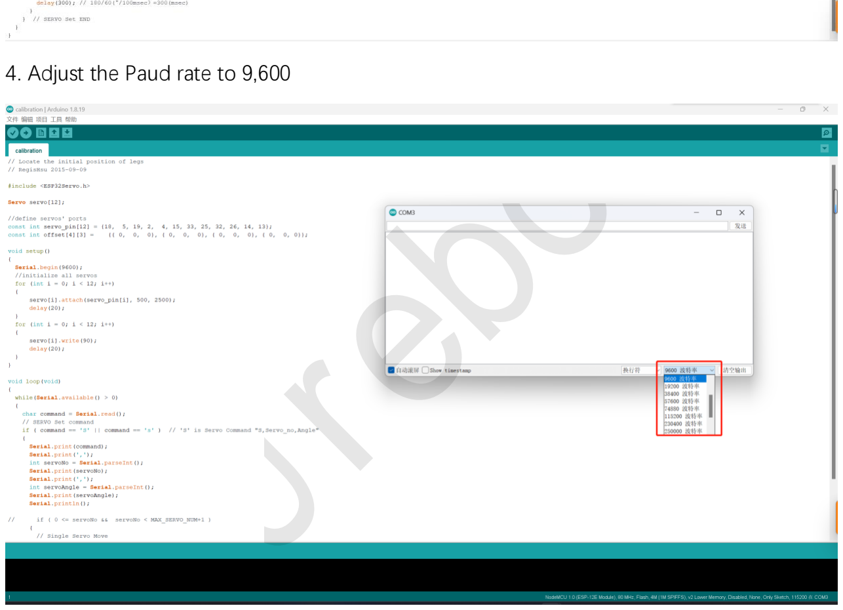
[picture p101: figure]
Urebot

4. Adjust the Paud rate to 9,600
5. After adjusting to 9600, enter s, 0,10 above
(S, 0,10 The 0 in the middle represents port 18 in the first array, the input 1 represents port 5, and so on)
(S, 0,10 after 10 represents the adjustment angle, and the general input value is probably between 20 and-20)
(After entering s, 0,10, click send, you will find that the rudder machine inserted in port 18 turns, then slowly adjust the correct number (keep parallel), and then record the final number) Example: For example, the final number recorded below me s, 0, xx is-5, s, 1, xx final, parallel value is-10 (the value of each device is different, the picture is for reference only)

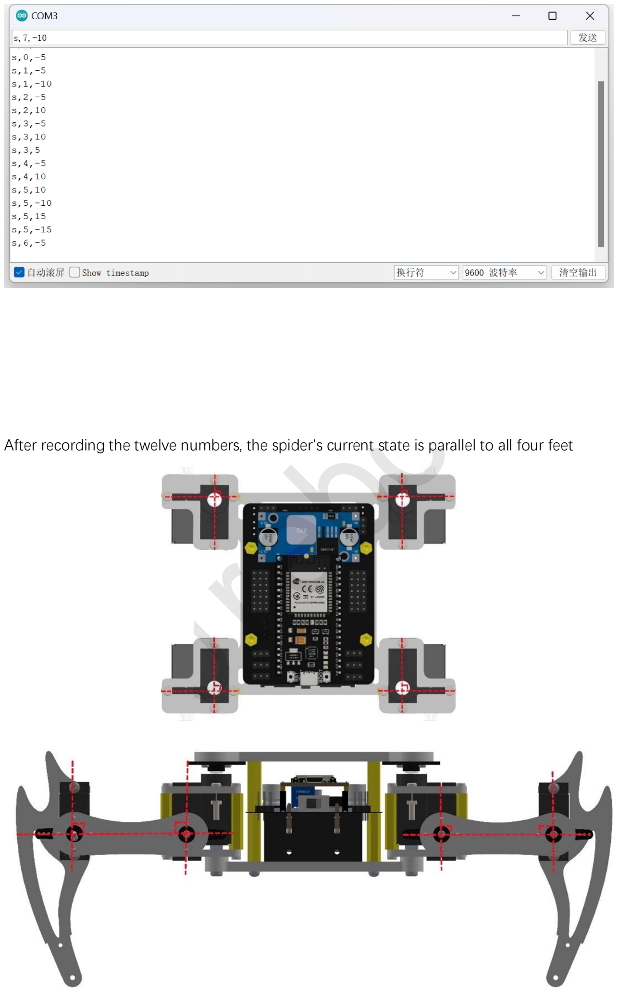
[picture p102: page 5]

After recording the twelve numbers, the spider's current state is parallel to all four feet

# Urebot

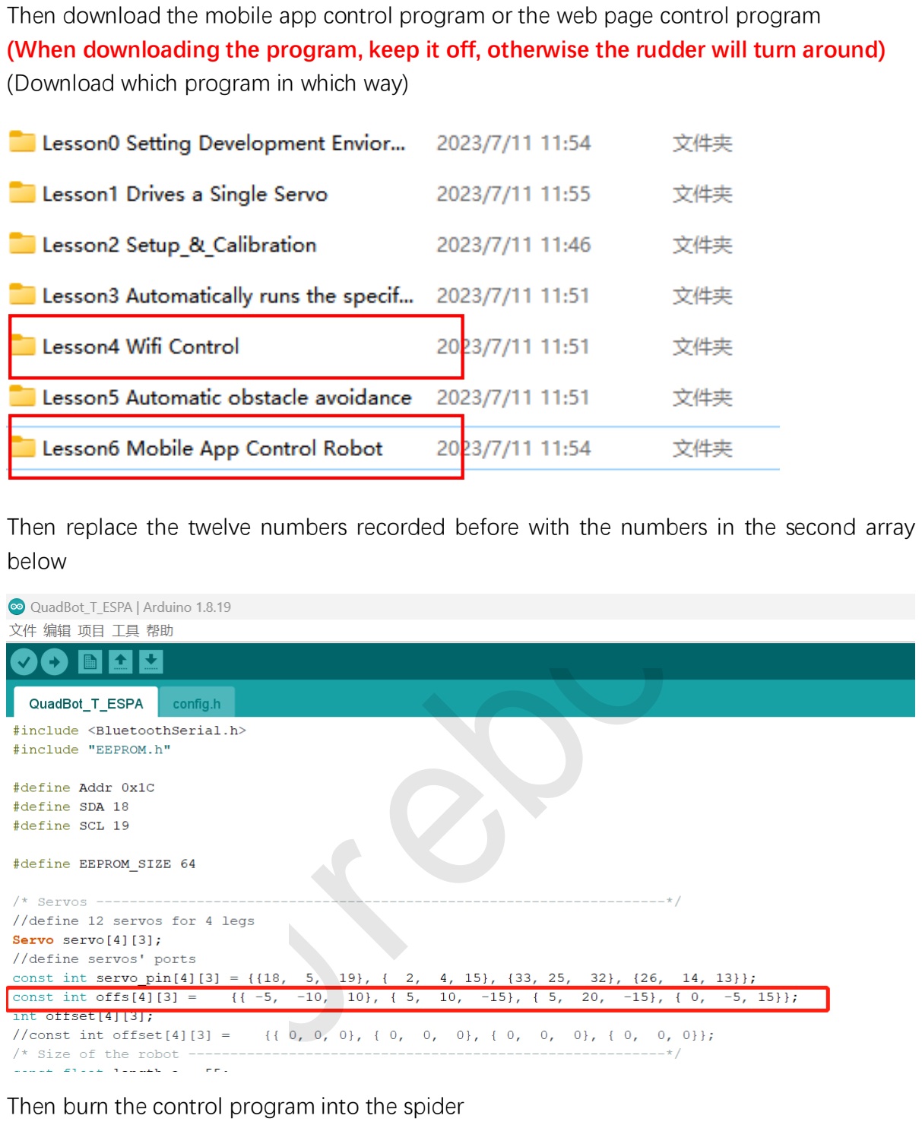
[picture p103: page 6]

Then download the mobile app control program or the web page control program (When downloading the program, keep it off, otherwise the rudder will turn around) (Download which program in which way)

Then replace the twelve numbers recorded before with the numbers in the second array below

Then burn the control program into the spider

# Urebot
