shunliuniliu/QuadBot-TD/QuadBot-TAD-EN/02_Manual/Calibration Manual.pdf

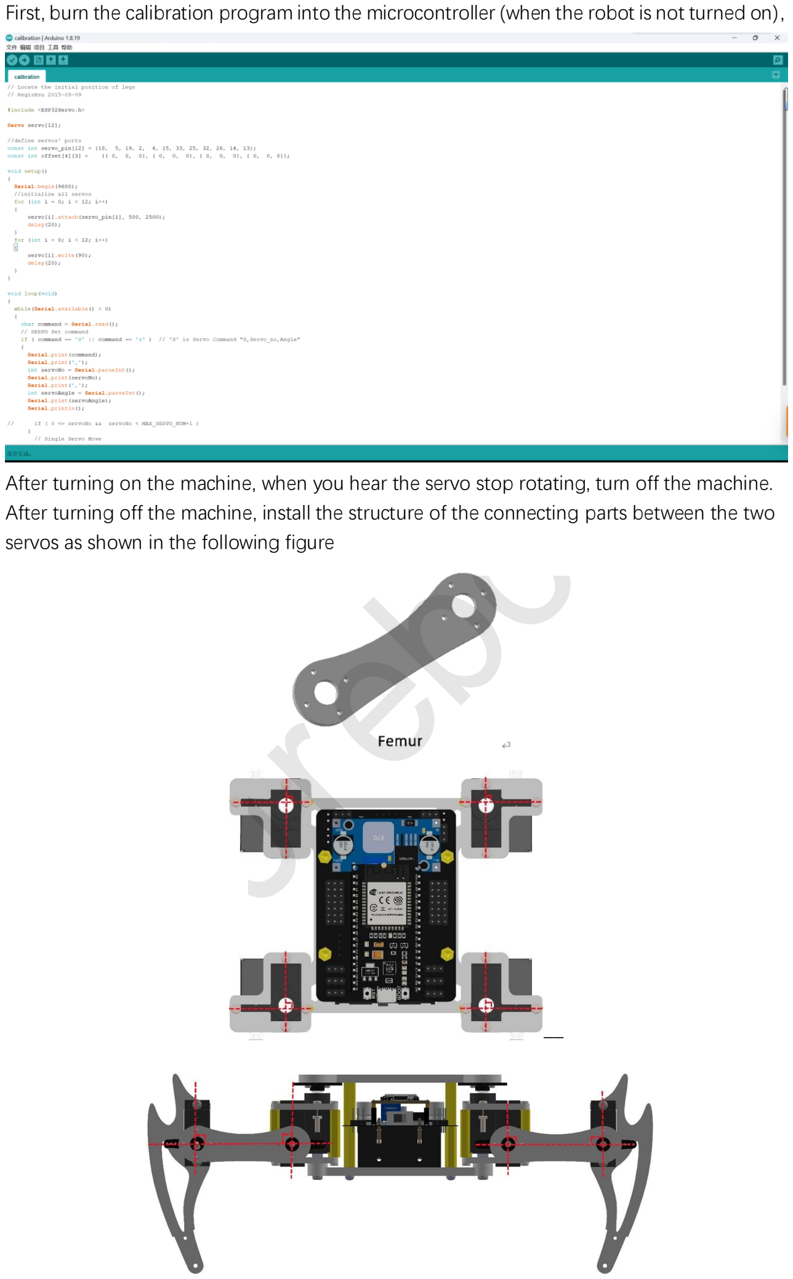
[picture p104: page 1]

First, burn the calibration program into the microcontroller (when the robot is not turned on)，

After turning on the machine, when you hear the servo stop rotating, turn off the machine. After turning off the machine, install the structure of the connecting parts between the two servos as shown in the following figure

––

# Urebot

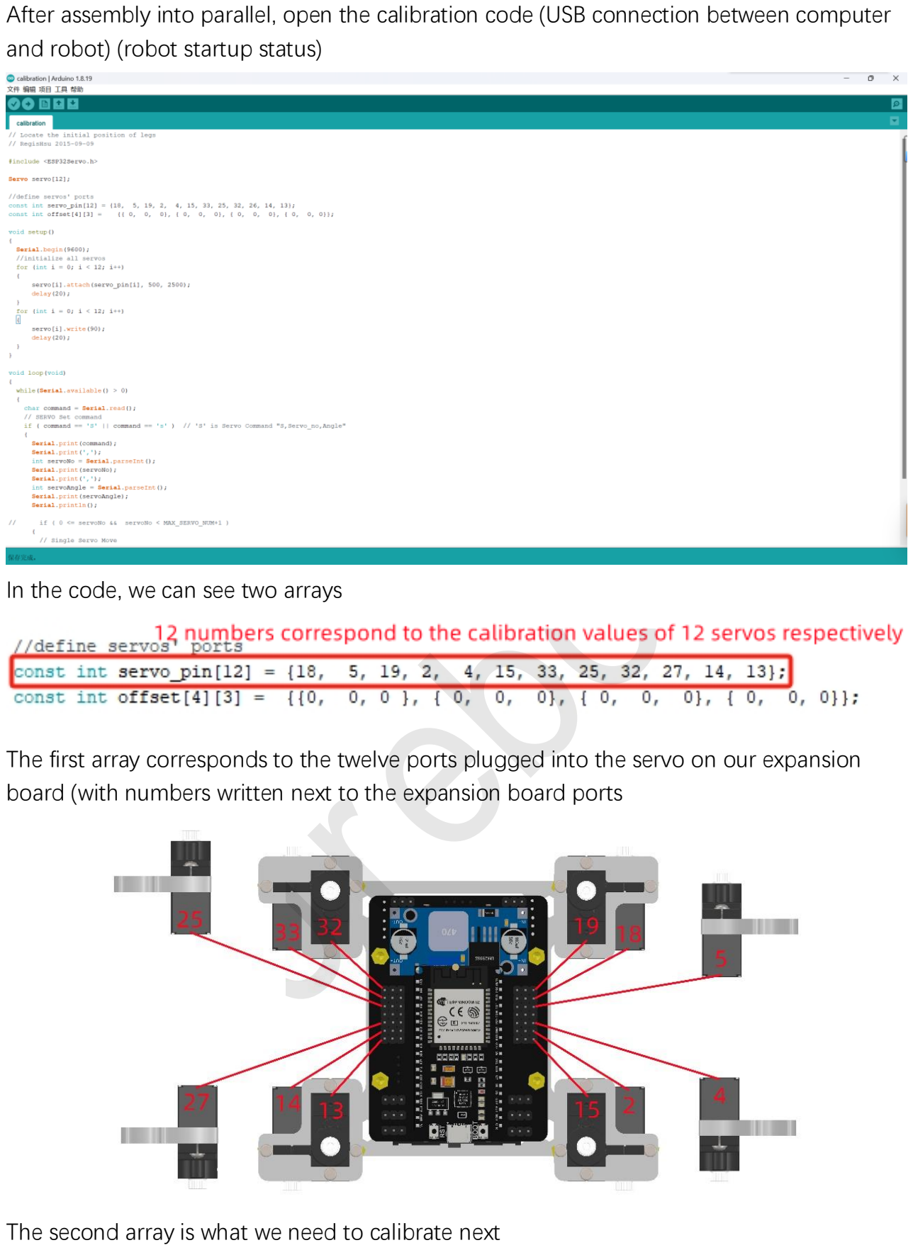
[picture p105: page 2]

After assembly into parallel, open the calibration code (USB connection between computer and robot) (robot startup status)

In the code, we can see two arrays

The first array corresponds to the twelve ports plugged into the servo on our expansion board (with numbers written next to the expansion board ports

The second array is what we need to calibrate next

# Urebot

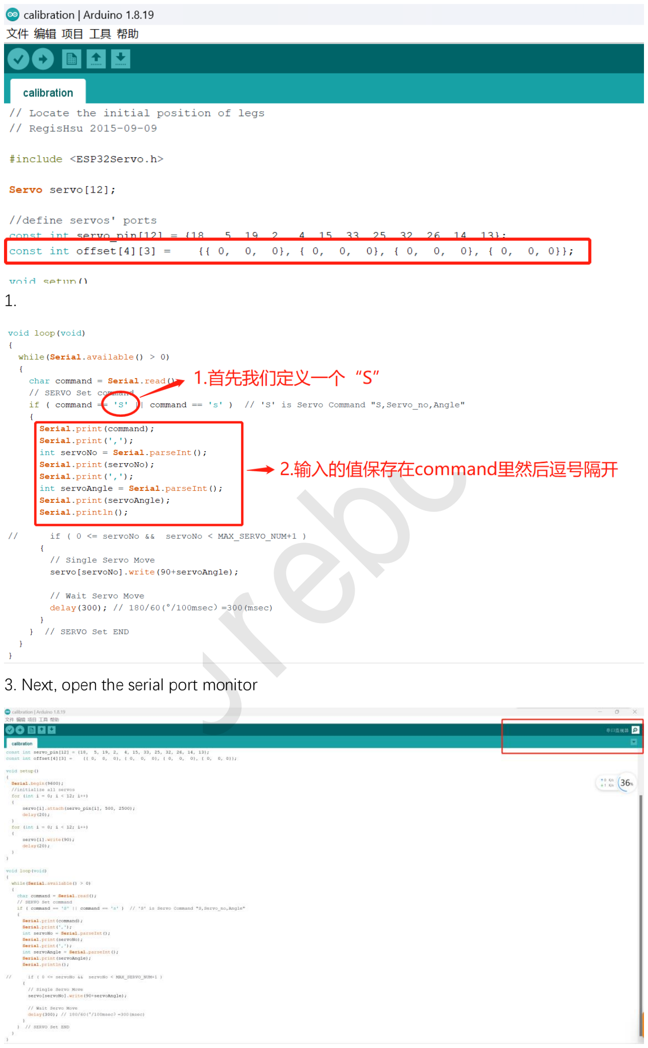
[picture p106: page 3]

1.

3. Next, open the serial port monitor

# Urebot

4. Adjust the baud rate to 9600

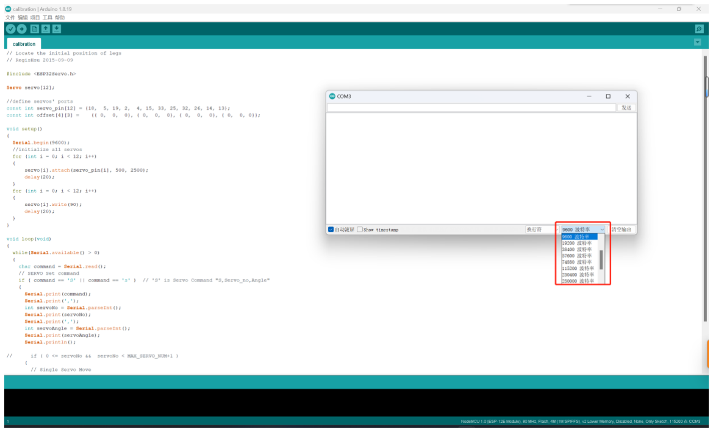
[picture p107: figure]

5. After adjusting to 9600, enter s, 0,10 on it
(The 0 between s, 0, 10 represents port 18 in the first string array, input 1 represents port 5, and so on)
(The 10 after s, 0, and 10 represents the adjusted angle, and generally the input value is between 20 and -20)
(Enter s, 0, 10, and then click send. You will notice that the servo motor inserted in port 18 has rotated a bit, and then slowly adjust the angle (keeping parallel) by inputting the correct number again, and then record the final number.)
For example, the final number recorded below s, 0, xx is -5, s, 1, xx, and the final parallel value is -10 (the values for each device are different, and the pictures are for reference only)

# Urebot

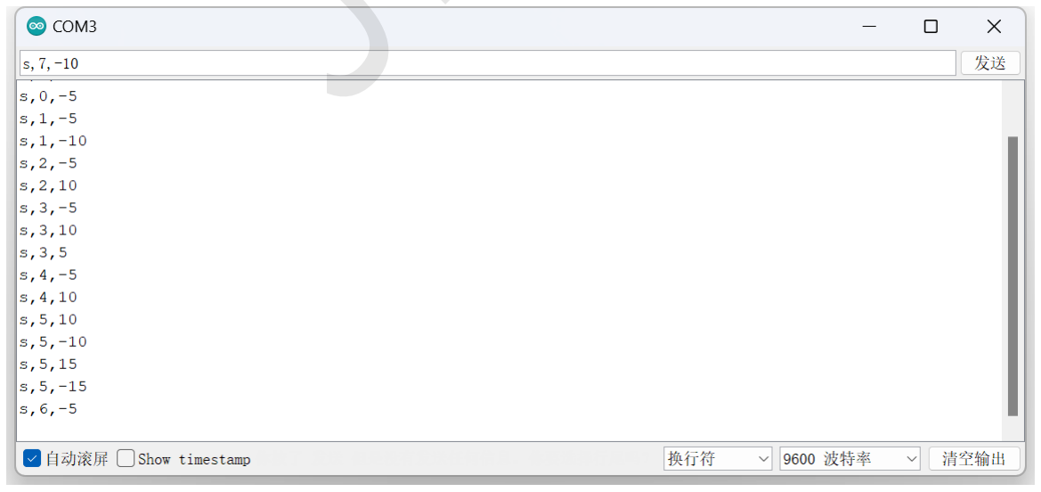
[picture p108: figure]

After recording the twelve numbers, the spider's current state is that all four feet are parallel

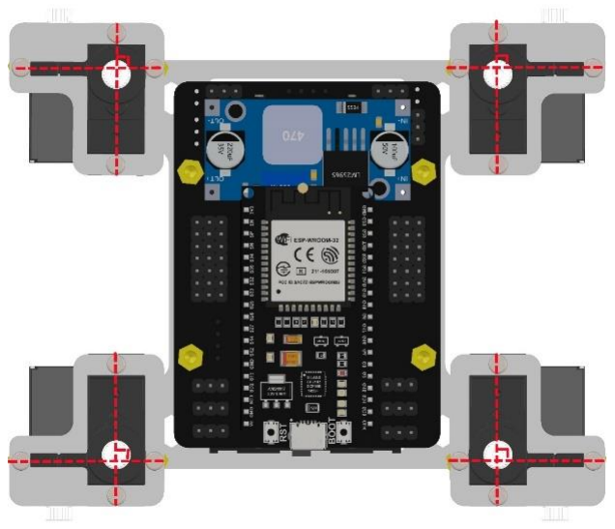
[picture p109: figure]
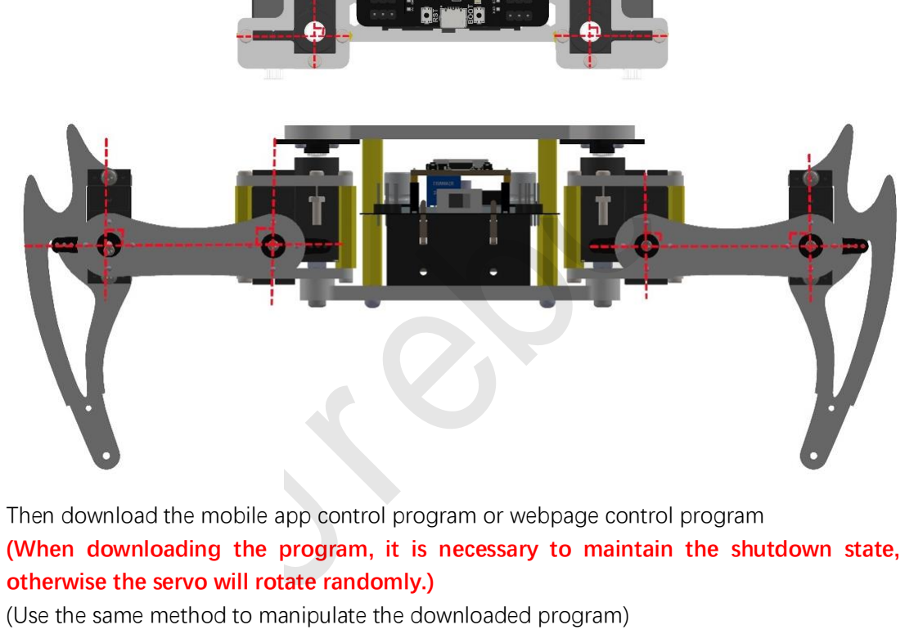
[picture p110: figure]
Urebot

Then download the mobile app control program or webpage control program
(When downloading the program, it is necessary to maintain the shutdown state, otherwise the servo will rotate randomly.)
(Use the same method to manipulate the downloaded program)

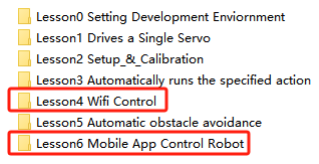
[picture p111: figure]

Then replace the twelve numbers previously recorded with the numbers in the second string array below

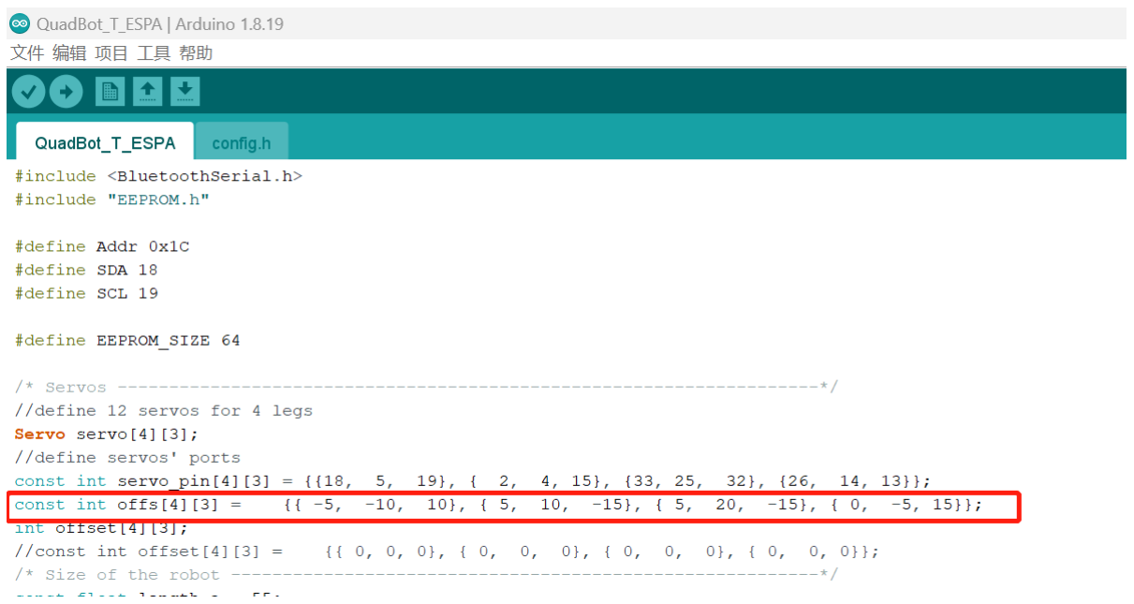
[picture p112: figure]

And then burn the control program into the robot

# Urebot
