shunliuniliu/QuadBot-TD/QuadBot-TAD-EN/05_Schematic/DC-DC power regulator module.pdf

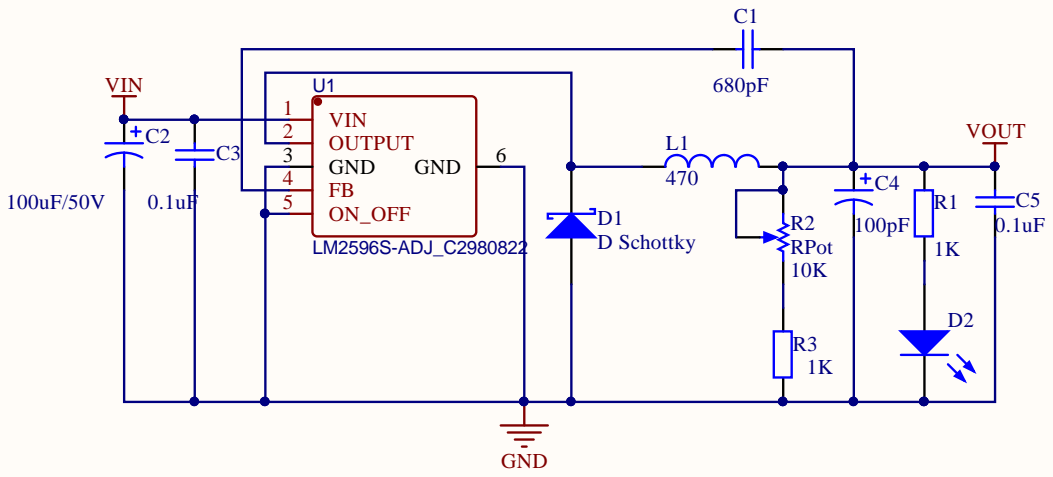
[picture p113: page 1]

n-Board-VD1.Sch rawnD Byoc

# Board Stack Report
