shunliuniliu/QuadBot-TD/QuadBot-TAD-EN/05_Schematic/Servo Shield.pdf

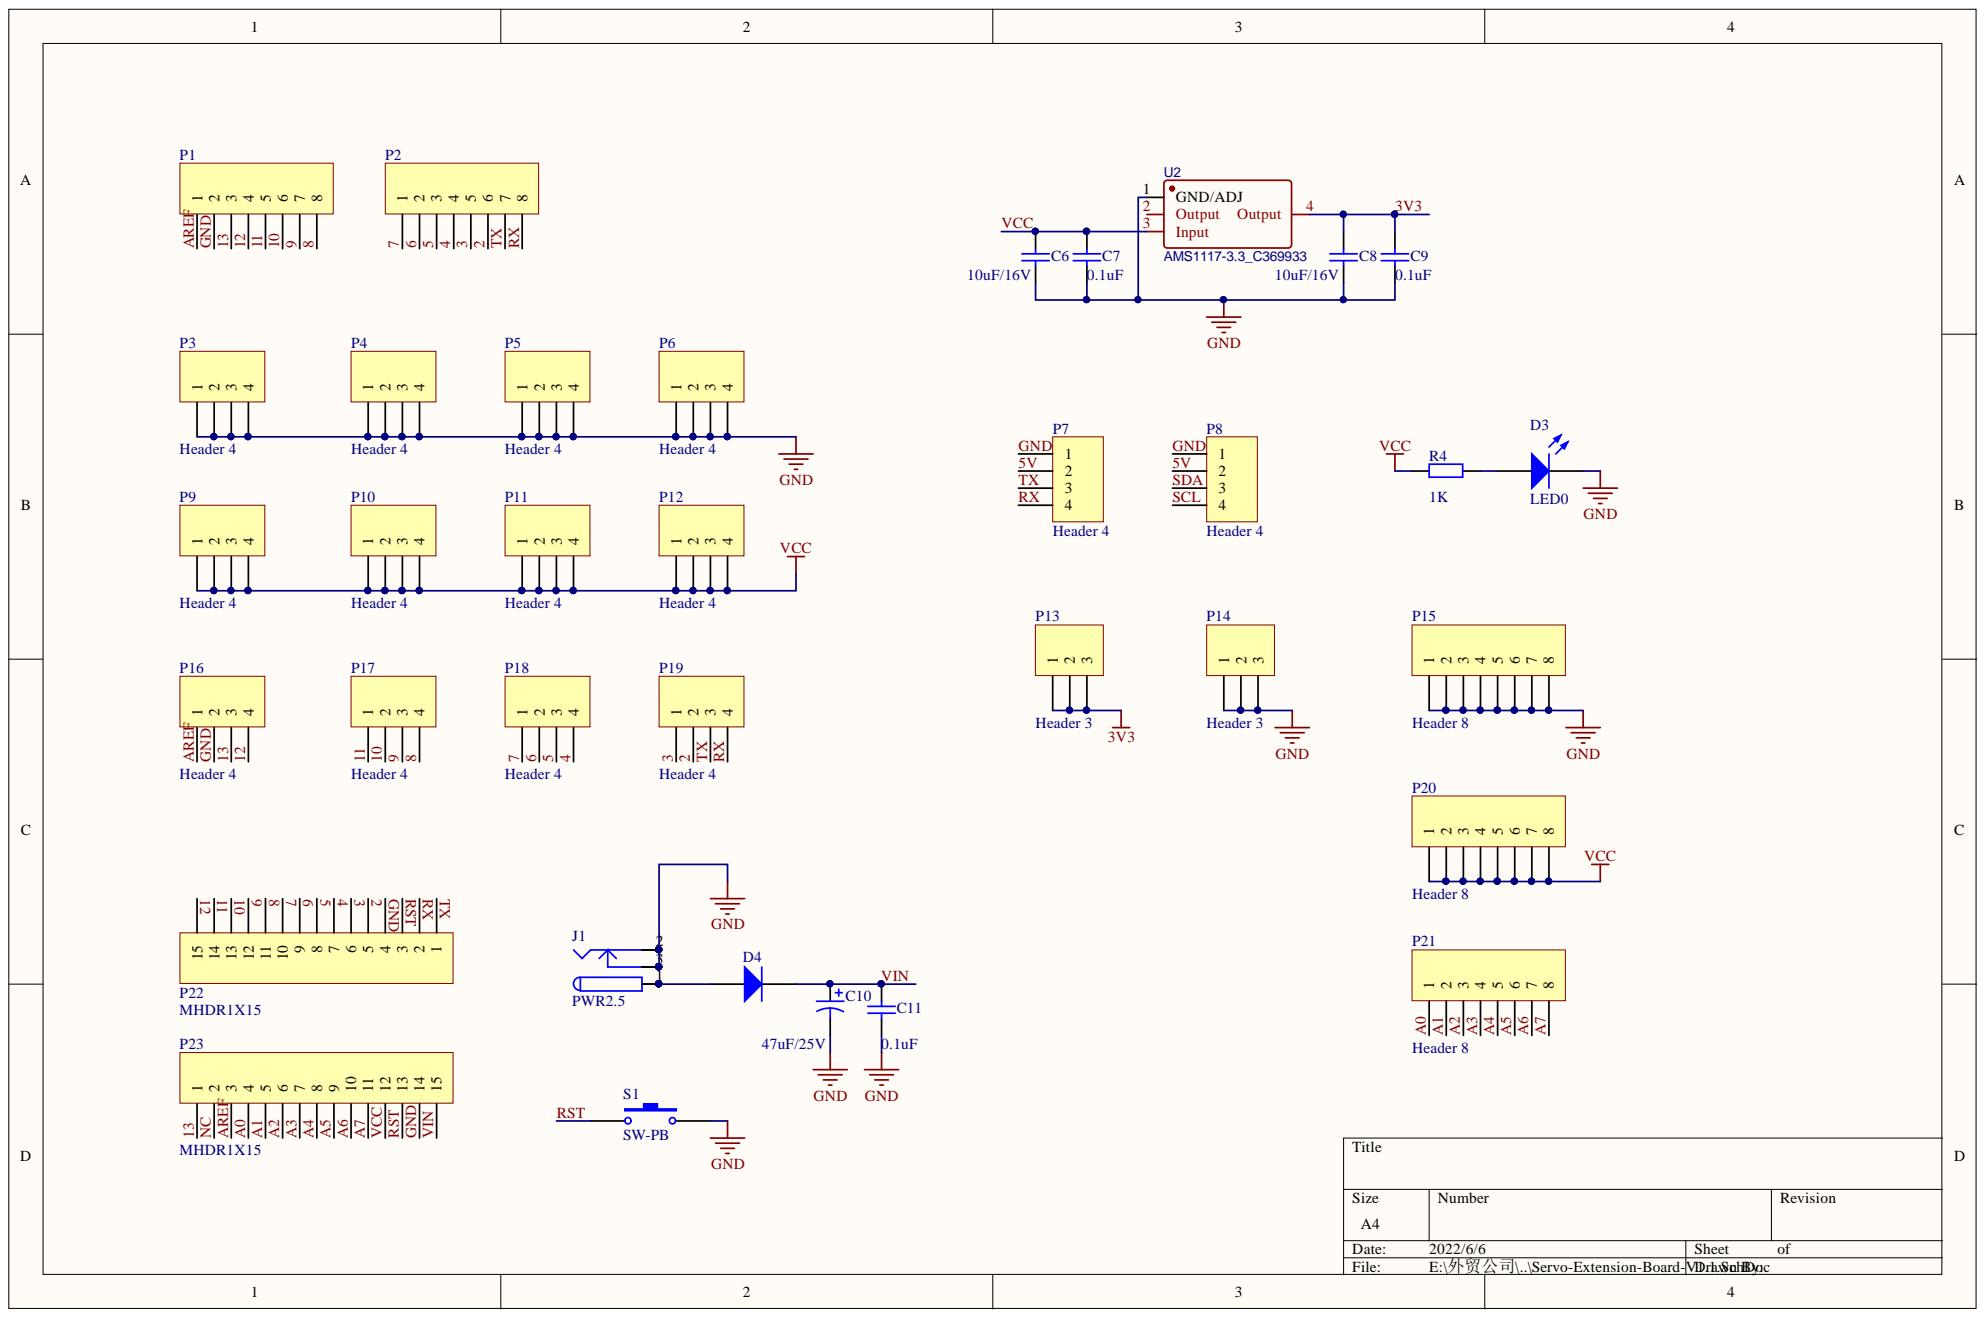
[picture p114: page 1]

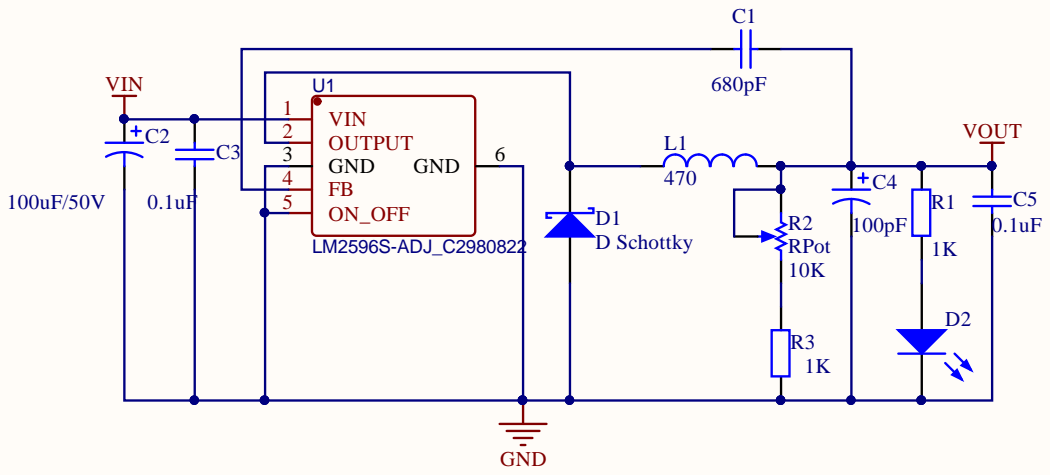
[picture p115: page 2]

n-Board-VD1.Sch rawnD Byoc

# Board Stack Report
