shunliuniliu/QuadBot-TD/QuadBot-TAD-EN/03_Tutorial_&_Code/Lesson6 Mobile App Control Robot/Lesson6 Mobile App Control Robot/QuadBot_TAD_APP/config.h

#ifndef CONFIG_H
#define CONFIG_H

//左前腿
#define LEFT_FRONT_TIBIA 0
#define LEFT_FRONT_FEMUR 1
#define LEFT_FRONT_COXA  2
//左后腿
#define LEFT_BACK_TIBIA 3
#define LEFT_BACK_FEMUR 4
#define LEFT_BACK_COXA  5
//右后腿
#define RIGHT_BACK_TIBIA 6
#define RIGHT_BACK_FEMUR 7
#define RIGHT_BACK_COXA  8
//右前腿
#define RIGHT_FRONT_TIBIA 9
#define RIGHT_FRONT_FEMUR 10
#define RIGHT_FRONT_COXA  11

#endif
